mawson-rovers/hestia/hestia-pcb/images/hestia-back-angle-20220521.png

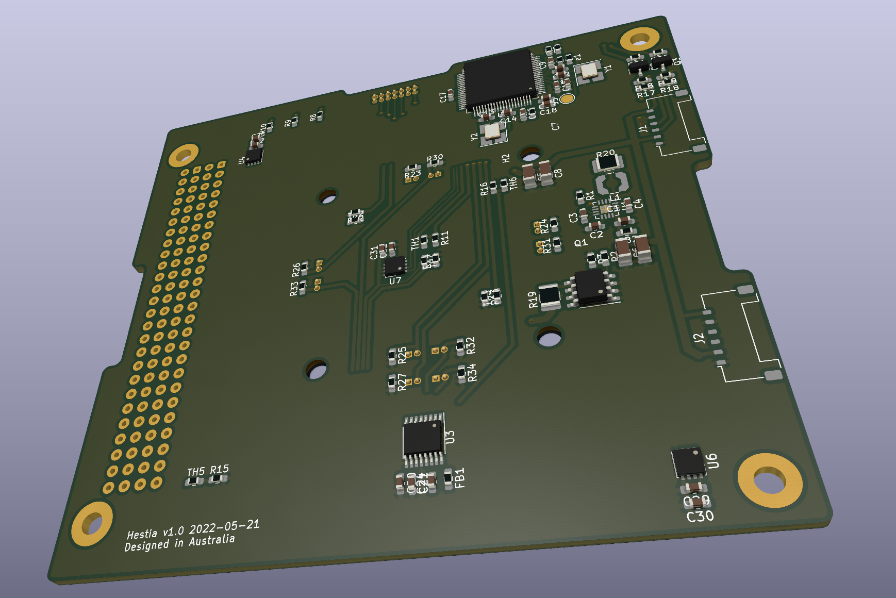
hestia-pcb/images/hestia-back-angle-20220521.png
