mawson-rovers/hestia/hestia-pcb/images/hestia-front-angle-20220521.png

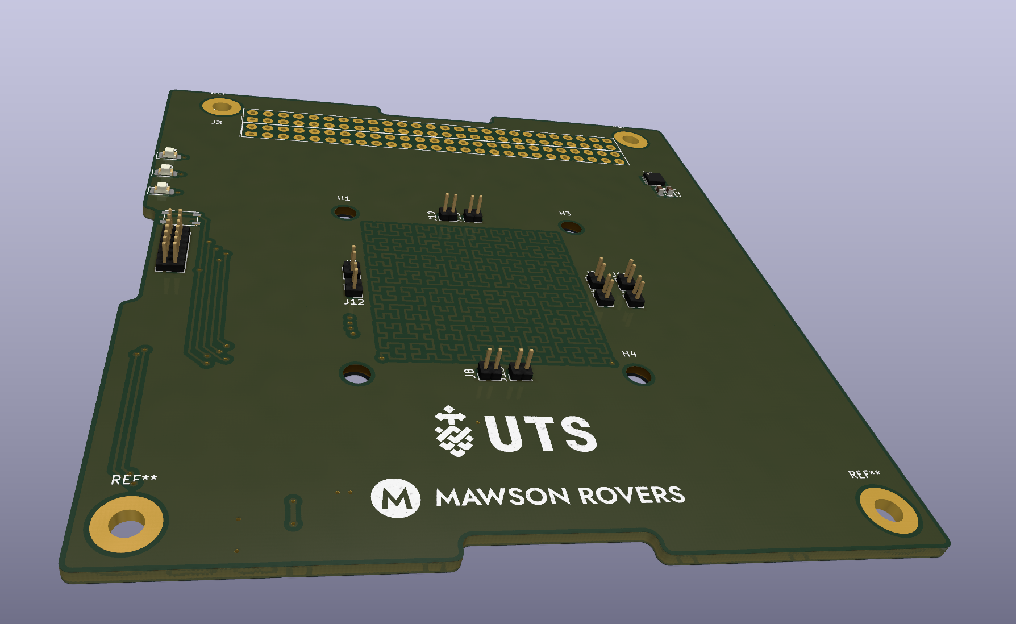
hestia-pcb/images/hestia-front-angle-20220521.png
