mawson-rovers/hestia/hestia-sat/BEAGLEBONE.md

## Setting up a BeagleBone Black

The Hestia software is designed to run on a BeagleBone Black (BBB) payload computer, connected to the Hestia board over I2C.

To set up a new BBB from scratch, you need to:

* Connect the BBB via USB to your computer, log in via SSH using `debian`/`temppwd`

* Configure internet sharing so the BBB can connect to the internet via the USB connection:
    * For Mac, enable Internet Sharing in the Sharing preference pane, then run `/opt/scripts/network/usb_mac_ics.sh` on
      the BBB
    * For Linux, you will need to configure NAT on the USB interface, then can run a similar
      script `/opt/scripts/network/`

* Install driver and configure the wi-fi with the TP-Link TL-WN725N dongle:

```sh
$ sudo apt update
$ sudo apt install git make gcc build-essential linux-headers-4.19.94-ti-r42
$ mkdir -p ~/src && cd ~/src
$ git clone https://github.com/lwfinger/rtl8188eu.git
$ cd rtl8188eu
$ make all
$ sudo make install
$ sudo reboot
$ sudo connmanctl
#connmanctl> tether wifi off
#connmanctl> enable wifi
#connmanctl> scan wifi
#connmanctl> services
#connmanctl> agent on
#connmanctl> connect wifi_*_managed_psk  # <- get this value from the services list above
#connmanctl> quit
```

(For the TP-Link AC600 Wi-Fi dongle - the one with the antenna - install the
[rtl8812au](https://github.com/aircrack-ng/rtl8812au.git) driver instead.)

### Update the hostname

Update the following files to set your Beaglebone to a unique hostname (we normally use b1, b2, etc).

* `/etc/hostname`
* `/etc/hosts`

Then change the hostname on the Avahi mDNS daemon. This allows you to ping `b7.local` (for example) over the network.

```sh
$ sudo hostname b7
$ sudo avahi-set-host-name b7
```

You just need to do this once; the OS and mDNS daemon will pick up the settings from `/etc/hostname` on the next reboot.

The Beaglebone should now be accessible via SSH over Wi-Fi.  Continue with the instructions in [INSTALL.md](INSTALL.md)
to install and configure the software.
