mawson-rovers/hestia/hestia-pcb/images/hestia-back-20220521.png

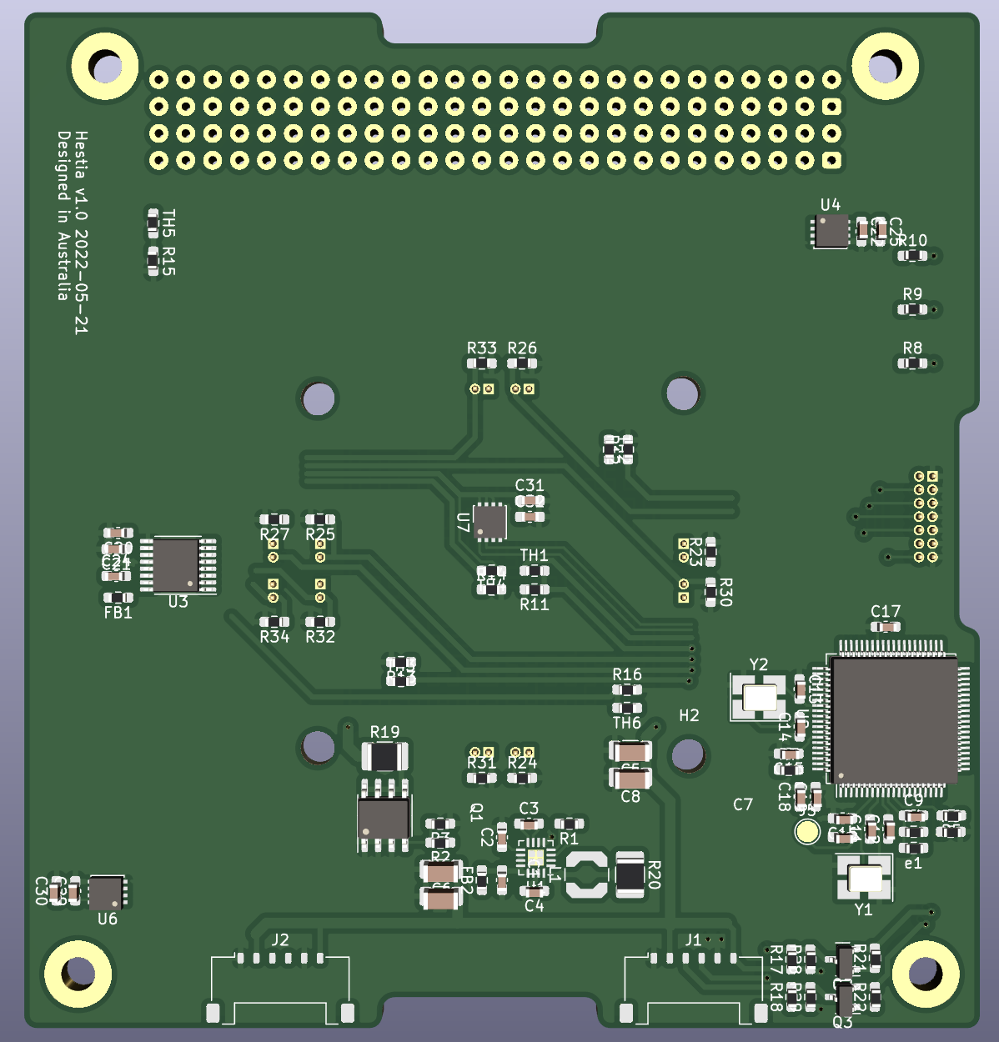
hestia-pcb/images/hestia-back-20220521.png
