mawson-rovers/hestia/ws-1/tcs-6u-main-asm-example.stp

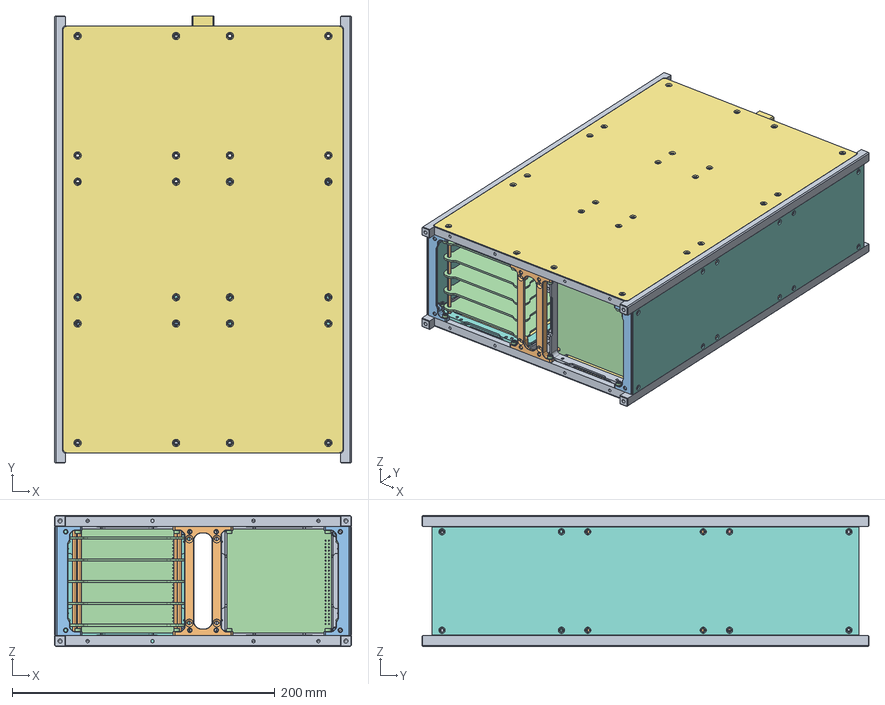
[picture p13: CAD file, 2022-05-23]
ws-1/tcs-6u-main-asm-example.stp
226.3 x 340.5 x 100.0 mm
ISIS-STSX-1-1-001 x 2
ISIS-STSX-1-1-002 x 6
ISIS-STSX-1-1-003 x 4
DIN912_M2_5X8 x 40
ISIS-STSX-1-1-005 x 2
ISIS-STSX-1-1-004 x 2
ISIS-STSX-1-1-006 x 2
ISIS-STSX-1-2-001 x 4
ISIS-STSX-1-2-002 x 4
ISIS-STSX-1-2-003 x 12
ISO14581_M2X6 x 32
PC104_PCB_REVD x 26
ISIS-STSX-1-2-004 x 4
ISO14581_M2_5X8 x 32
TCS-6U-BMSP-6U-EXAMPLE x 2
TCS-6U-BMSP-3U-EXAMPLE x 2
