mawson-rovers/hestia/hestia-pcb/3dmodels/Molex_Pico-Lock_504050-0691_1x06-1MP_P1.50mm_Horizontal.step

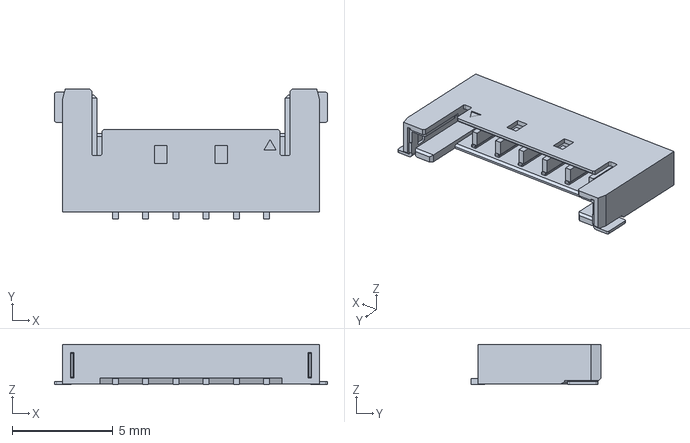
[picture p14: CAD file, 2023-07-20]
hestia-pcb/3dmodels/Molex_Pico-Lock_504050-0691_1x06-1MP_P1.50mm_Horizontal.step
13.6 x 6.44 x 2.00 mm
