mawson-rovers/hestia/hestia-sat/flight-programs/test7/test7.md

### Matilda Flight Test 7

Goals:

* Re-run FT2 test to replicate results and check for PCM leaks
  * Note: needs to be run during eclipse - same as XLB did on 27 Nov 2024 (see email)
* Run thermostat mode with target sensor on heatsink (J7) to test thermostat with PCM completely melted
