mawson-rovers/hestia/var/logs/ws1-test-2023-09-26/uts-data-1970-01-01-raw.csv

UTC | board | TH1 | TH2 | TH3 | U4 | U5 | U6 | U7 | TH4 | TH5 | TH6 | J7 | J8 | J12 | J13 | J14 | J15 | J16 | heater_v_high | heater_v_low | heater_curr | heater_mode | target_temp | target_sensor | heater_duty | max_temp | flags
1970-01-01 00:08:36.550837 | 1 | 2313 | 2246 | 2293 | 5932 | 5790 | 5800 | 8144 | 2331 | 1977 | 2248 | 2078 |  | 2083 | 2115 | 2092 |  |  | 3039 | 3036 | 4095 | 0 | 1044 | 0 | 255 | 3893 | 1
1970-01-01 00:08:36.550837 | 2 | 2211 | 2173 | 2202 | 5789 | 5689 | 5808 | 7248 | 2195 | 1958 | 2151 | 2055 |  | 2057 | 2065 | 2039 |  |  | 2956 | 61 | 23 | 2 | 1044 | 0 | 255 | 3893 | 1
1970-01-01 00:08:41.599771 | 1 | 2261 | 2223 | 2255 | 5951 | 5812 | 5818 | 7792 | 2278 | 1980 | 2226 | 2084 |  | 2088 | 2117 | 2093 |  |  | 3048 | 3036 | 4095 | 0 | 1044 | 0 | 255 | 3893 | 1
1970-01-01 00:08:41.599771 | 2 | 2323 | 2241 | 2299 | 5803 | 5701 | 5812 | 8002 | 2316 | 1960 | 2210 | 2051 |  | 2060 | 2067 | 2044 |  |  | 2959 | 61 | 23 | 2 | 1044 | 0 | 255 | 3893 | 1
1970-01-01 00:08:46.659794 | 1 | 2232 | 2211 | 2233 | 5971 | 5825 | 5826 | 7595 | 2247 | 1984 | 2212 | 2087 |  | 2087 | 2119 | 2091 |  |  | 3055 | 3036 | 4095 | 0 | 1044 | 0 | 255 | 3893 | 1
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
