mawson-rovers/hestia/var/logs/ws1-test-2023-09-26/uts-data-1970-01-01.csv

UTC | board | TH1 | TH2 | TH3 | U4 | U5 | U6 | U7 | TH4 | TH5 | TH6 | J7 | J8 | J12 | J13 | J14 | J15 | J16 | heater_v_high | heater_v_low | heater_curr | heater_mode | target_temp | target_sensor | heater_duty | max_temp | flags
1970-01-01 00:08:36.550837 | 1 | 31.51 | 29.83 | 31.01 | 23.17 | 22.62 | 22.66 | 31.81 | 31.97 | 23.31 | 29.88 | 25.72 |  | 25.84 | 26.61 | 26.06 |  |  | 4.97 | 4.97 | 3.35 | OFF | 0.86 | TH1 | 255 | 120.50 | OK
1970-01-01 00:08:36.550837 | 2 | 28.96 | 28.02 | 28.74 | 22.61 | 22.22 | 22.69 | 28.31 | 28.56 | 22.86 | 27.49 | 25.17 |  | 25.22 | 25.41 | 24.78 |  |  | 4.84 | 0.10 | 0.02 | PWM | 0.86 | TH1 | 255 | 120.50 | OK
1970-01-01 00:08:41.599771 | 1 | 30.20 | 29.26 | 30.05 | 23.25 | 22.70 | 22.73 | 30.44 | 30.63 | 23.38 | 29.33 | 25.86 |  | 25.96 | 26.66 | 26.08 |  |  | 4.99 | 4.97 | 3.35 | OFF | 0.86 | TH1 | 255 | 120.50 | OK
1970-01-01 00:08:41.599771 | 2 | 31.77 | 29.70 | 31.16 | 22.67 | 22.27 | 22.70 | 31.26 | 31.59 | 22.91 | 28.93 | 25.07 |  | 25.29 | 25.46 | 24.90 |  |  | 4.84 | 0.10 | 0.02 | PWM | 0.86 | TH1 | 255 | 120.50 | OK
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
