mawson-rovers/hestia/(threads)

Thread 15 (2023-01-23):

Test multiple boards on a single power supply, separate I2C buses

mryall-mawson, 2023-01-23:

mryall-mawson, 2023-07-10:
Tested and working via CLI:

* Enabled heater on top board, heated up to 100°C. Could see marginal increase in temperature (24°C → 26°C) on bottom board.
* Enabled heater on bottom board, heated up to 120°C, which disabled the top heater
* Confirmed logging includes both boards' data
* Confirmed CLI status shows both boards' temperature and targets.

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

Closed 2023-07-10.

Thread 24 (2023-02-06):

Test MSP430 ADC internal resistance with a known resistor divider

mryall-mawson, 2023-02-06:

mryall-mawson, 2023-06-20:
While debugging some issues, we have measured voltage and confirmed ADC behaviour on board v2. It's within 0.02V (<1% error).

Closed 2023-06-20.

Thread 28 (2023-05-29):

Electronics fixes for v2.1

mryall-mawson, 2023-05-29:
Things to tidy up:
* Footprints for inductor, diodes, etc.
* LED resistors - red & blue bright
* Update KiCAD
* Increase diameter/spacing of SW2

JDMawson, 2023-06-17:
inductor footprint changed. diode footprint changed. Most of DRC issues resolved. Mawson Rovers logo and UTS logo need to be rereferenced from the Hestia footprint libraries but they seem to be different sizes from those in the libraries. Maybe the better solution is to create new library footprints from the logos already on the PCB. Smartsat and SpiralBlue logos seem to be only on the PCB and not referenced from libraries but are listed as footprint elements. Perhaps they can also be copied into footprint libraries and referenced. The logos should be given different footprint designator names.

JDMawson, 2023-06-18:
i think I've finished shifting all the designators and adding text. DRC is satisfied.

JDMawson, 2023-06-18:
having a look at the build artifacts. How are some components being excluded. i see most of the thruhole have been removed from the BOM but there is still one thruhole component present in the BOM. Would it be possible to create two BOM files - one for SMD and one for thruhole?

mryall-mawson, 2023-06-20:
@JDMawson I had a look at the BOM config in the [hestia.kibot.yml](https://github.com/mawson-rovers/hestia/blob/main/hestia-pcb/hestia.kibot.yml) config file, and can't see any reason why THT components would be (mostly) excluded. I think manual export from KiCAD is probably easiest at this stage, and we can look into automating it as a later enhancement.

Closing this issue off as the original items have been fixed. Issue #38 covers the problem with the current measurement, and issue #35 covers the heater trace. I'll raise a new one for the actual fabrication too.

Closed 2023-06-20.

Thread 29 (2023-05-29):

Rolling average sampling for voltage & current measurement

mryall-mawson, 2023-05-29:
Need to ensure this works correctly with PWM as well.

Closed 2023-09-26.

Thread 30 (2023-05-31):

Implement voltage & current measurement

mryall-mawson, 2023-05-31:
We have the circuitry, now need to implement the software:

* Ensure firmware can correctly read from ADC
* Convert values to voltages and current in software
* Add to logger and web API
* Adjust UI to show values on chart and status panel

Closed 2023-06-18.

Thread 32 (2023-06-06):

Log other data even if check sensor fails

mryall-mawson, 2023-06-06:
CLI should use the check sensor to prevent delays, but the logger can rely on config to disable boards that aren't available.

mryall-mawson, 2023-06-21:
This was mostly a problem when the I2C pins were not configured. Now that they are configured correctly on the Beaglebone (via config-pin), the read operations return quickly if there is no signal.

Closed 2023-06-21.

Thread 34 (2023-06-19):

Use green LED as PID indicator

mryall-mawson, 2023-06-19:
The current firmware is flashing the green LED every 1s based on the timer. We should make this flash only when PID mode is operating, so it works as an indicator.

mryall-mawson, 2023-06-20:
Tested and confirmed working

Closed 2023-06-20.

Thread 35 (2023-06-19):

Heater trace resistance too low on board v2

mryall-mawson, 2023-06-19:
When connected to 5V power supply, we see current above 3A. Measured heater trace resistance on board v2 is 1.6Ω vs 2.2Ω in board v1.1.

After discussion with @JDMawson we agreed to reduce track width to compensate, from 0.28mm to 0.18mm. This should increase resistance to the desired 2.5Ω.

Root cause unclear. Perhaps PCBWay (v2 manufacturer) copper is thicker than JCLPCB (v1.1 manufacturer), or there is a difference in the physical stack-up we chose.

mryall-mawson, 2023-06-19:
Need to confirm this fix when we get board v2.1 back.

mryall-mawson, 2023-07-03:
Tested a variety of heater trace widths on 4-layer boards from PCBWay and found that we need to use a 0.15mm track width, plus some manual testing to verify resistance is high enough before board loading.

Added a test pad TP7 on the low side of the heater for easy manual testing during fabrication.

Closed 2023-07-03.

Thread 36 (2023-06-20):

Can't update via web interface, buttons don't work

mryall-mawson, 2023-06-20:
Web interface wasn't working during testing last night. Had to use CLI to turn heater on and off.

Found an error about "Origin not permitted" in the JS log files.

Closed 2023-06-20.

Thread 38 (2023-06-20):

Current measurement via INA826 is not working correctly

mryall-mawson, 2023-06-20:
Measured via a multimeter in series, we can see current of >3A, while the ADC is reporting ~1.7V.

Testing has confirmed the instrumentation amp (part INA826; designator U10) is reporting a lower than expected voltage.

Current theory is that we may have connected the REF pin on INA826 incorrectly, but needs further investigation.

mryall-mawson, 2023-06-20:
Confirmed that if the input starts at 3.2A, then down to 2.2A, then back up to 3.2A again, that the measured current on the INA826 does decrease (1.67 → 1.61) and then rise slightly (1.60 → 1.65):

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

Here's the raw data:

```csv
2023-06-20 05:01:27.442862,2,24.47,24.45,25.26,24.34,23.70,23.68,24.74,24.24,24.26,24.28,,,,,,,,5.01,5.00,0.01,OFF,79.98,TH1,255
2023-06-20 05:01:32.472310,2,25.98,26.54,27.83,24.35,23.71,23.67,26.04,25.82,24.26,26.30,,,,,,,,4.22,0.08,1.71,PWM,79.98,TH1,255
2023-06-20 05:01:37.501913,2,34.43,38.59,42.80,24.36,23.71,23.70,34.92,34.72,24.26,37.12,,,,,,,,4.24,0.08,1.70,PWM,79.98,TH1,255
2023-06-20 05:01:42.533126,2,40.81,48.16,55.23,24.39,23.71,23.74,42.54,41.43,24.31,45.65,,,,,,,,4.24,0.08,1.69,PWM,79.98,TH1,255
2023-06-20 05:01:47.562953,2,45.45,55.23,64.63,24.49,23.77,23.84,48.34,46.32,24.33,52.06,,,,,,,,4.50,0.07,1.67,PWM,79.98,TH1,255
2023-06-20 05:01:52.594303,2,49.07,60.61,72.03,24.67,23.80,23.97,52.90,50.07,24.40,57.11,,,,,,,,4.28,0.07,1.67,PWM,79.98,TH1,255
2023-06-20 05:01:57.623850,2,51.20,64.09,76.73,24.85,23.88,24.14,55.89,52.39,24.50,60.12,,,,,,,,3.31,0.06,1.61,PWM,79.98,TH1,255
2023-06-20 05:02:02.654415,2,50.88,63.37,75.99,25.12,23.98,24.32,55.97,52.03,24.62,59.68,,,,,,,,3.31,0.06,1.60,PWM,79.98,TH1,255
2023-06-20 05:02:07.699872,2,50.81,62.85,75.40,25.39,24.10,24.54,56.02,52.10,24.76,59.42,,,,,,,,3.33,0.14,1.60,PWM,79.98,TH1,255
2023-06-20 05:02:12.740105,2,51.23,62.80,75.60,25.64,24.24,24.76,56.41,52.47,24.95,59.60,,,,,,,,3.30,0.06,1.60,PWM,79.98,TH1,255
2023-06-20 05:02:17.768084,2,51.95,63.13,75.53,25.93,24.39,24.98,57.00,53.13,25.14,59.86,,,,,,,,3.31,0.06,1.60,PWM,79.98,TH1,255
2023-06-20 05:02:22.795785,2,52.69,63.51,75.73,26.19,24.61,25.25,57.70,53.85,25.31,60.21,,,,,,,,3.34,0.06,1.60,PWM,79.98,TH1,255
2023-06-20 05:02:27.825523,2,54.07,64.77,77.20,26.45,24.80,25.50,58.99,55.31,25.58,61.32,,,,,,,,4.28,0.07,1.65,PWM,79.98,TH1,255
2023-06-20 05:02:32.855403,2,57.65,69.16,82.66,26.68,25.04,25.73,62.66,58.99,25.82,65.17,,,,,,,,4.29,0.07,1.64,PWM,79.98,TH1,255
2023-06-20 05:02:37.888113,2,60.61,72.82,87.95,26.90,25.27,25.98,66.04,62.15,26.08,68.34,,,,,,,,4.29,0.07,1.64,PWM,79.98,TH1,255
2023-06-20 05:02:42.917952,2,63.13,75.66,91.31,27.17,25.47,26.26,68.86,64.73,26.30,71.03,,,,,,,,4.31,0.07,1.63,PWM,79.98,TH1,255
2023-06-20 05:02:47.947541,2,65.17,77.97,94.47,27.39,25.74,26.49,71.22,66.80,26.54,72.88,,,,,,,,4.30,0.07,1.63,PWM,79.98,TH1,255
2023-06-20 05:02:52.977904,2,66.96,79.90,96.73,27.70,25.97,26.79,73.34,68.78,26.81,74.56,,,,,,,,4.31,0.07,1.63,PWM,79.98,TH1,255
2023-06-20 05:02:58.007708,2,68.83,81.64,99.02,28.06,26.20,27.03,75.27,70.51,27.02,76.26,,,,,,,,4.31,0.07,1.62,PWM,79.98,TH1,255
2023-06-20 05:03:03.039182,2,70.40,83.22,101.07,28.34,26.46,27.30,77.06,72.21,27.32,77.62,,,,,,,,4.31,0.07,1.62,PWM,79.98,TH1,255
2023-06-20 05:03:08.078846,2,71.91,84.45,102.55,28.68,26.70,27.59,78.63,73.74,27.56,78.89,,,,,,,,4.31,0.07,1.62,PWM,79.98,TH1,255
2023-06-20 05:03:13.108327,2,73.12,85.64,103.94,28.98,26.93,27.84,80.12,75.33,27.78,79.83,,,,,,,,4.30,0.07,1.61,PWM,79.98,TH1,255
2023-06-20 05:03:18.138152,2,71.68,82.26,100.16,29.29,27.19,28.13,78.82,73.43,28.10,76.93,,,,,,,,4.99,4.99,0.01,OFF,79.98,TH1,255
```

mryall-mawson, 2023-06-23:
@JDMawson I've tested a variety of currents through the heater trace & INA826, and in its existing configuration on board H202:

* Values up to ~1.5A are measured correctly. I got accurate measurements for 0.25A, 0.5A, 1.0A, 1.2A, 1.4A and 1.5A (comparing the power supply output to the log files).
* Values above 1.5A are truncated to a measurement of ~1.5-1.6. 1.6A measured as 1.55, 2A measured as 1.57.

My theory - with REF set to ground and supply rails of 0V/3.3V, we have configured the INA826 with a range of 3.3V around an offset of 0V. So the current configuration can measure from -1.65A to 1.65A, and the resolution decreases a bit near the edges.

Perhaps changing the REF pin to 1.65V would give us the expected range of 0-3.3V for an input current of 0-3.3A. Let's see how it works on the evaluation board.

mryall-mawson, 2023-07-10:
JD and I implemented a basic current sense resistor as a replacement to the amplifier on board v2.1.

It doesn't use the full range of the ADC, so we don't get very accurate measurement, and it uses a bit more power, but should still be okay.

Closed 2023-07-10.

Thread 39 (2023-06-20):

Show heater_duty on chart

mryall-mawson, 2023-06-20:
New uts-web interface doesn't show duty on chart.

We should show it with a range of 0.0-1.0, scaled appropriately for the heater mode (PID: 0-1000, PWM: 0-255).

Closed 2023-06-20.

Thread 40 (2023-06-20):

Get B3 + H113 setup working for testing

mryall-mawson, 2023-06-20:
Need to get back to a working version of the dashboard and firmware.

mryall-mawson, 2023-06-21:
I've updated the new software to work with the old board. It's a bit crufty, showing irrelevant voltage/current fields & lines, but it works as a stopgap.

Closed 2023-06-21.

Thread 41 (2023-06-20):

Submit order for v2.1 boards

mryall-mawson, 2023-06-20:
Submit an order once all the open issues in the [board-v2.1 milestone](https://github.com/mawson-rovers/hestia/milestone/2) are closed:

- #28
- #35
- #38

Closed 2023-07-10.

Thread 43 (2023-06-21):

Test board for various heater trace designs

mryall-mawson, 2023-06-21:
We should do a quick test board with heater traces of various widths, so we can confirm the resistance before fabricating the final board.

mryall-mawson, 2023-06-21:
I designed a test board with four heater traces, using track widths of 0.16, 0.18 (proposed new), 0.22 and 0.28 mm (original). KiCAD files for the PCB design are committed here: https://github.com/mawson-rovers/heater-trace-test

I've sent two versions off for fabrication with PCBWay tonight. The 2-layer version costs $5 and has a 24h turnaround time, so I made one of those even though the copper thickness may not be representative. The real test is a 4-layer board, which is estimated to take 4-5 days for fabrication, then another 3-4 days for shipping.

Closed 2023-06-21.

Thread 44 (2023-07-03):

New software can’t read all sensors on v1.1 boards

mryall-mawson, 2023-07-03:
The Python code seems to read a bunch of sensors that the new Rust code can’t. Needs investigation when we get a v1.1 board back in the office.

mryall-mawson, 2023-10-16:
Not fixing this.

Closed 2023-10-16.

Thread 45 (2023-07-03):

Timestamps out of order in log files

mryall-mawson, 2023-07-03:
There’s some kind of intermittent logging issue where older timestamps are interspersed with newer ones.

Laryssa sent an example that I’ll post here shortly.

mryall-mawson, 2023-07-20:
Laryssa showed me an example of this at Tech Lab today. It looks like the following happens from the perspective of the Beaglebone system:

- Time t1: log some sensor data
- t2: store the current time (t2) in some kind of non-volatile storage in case of a power/network failure
- t3: log more sensor data
- t4: power is disconnected, system halts
- t2': power is restored, system restarts and starts logging data again, but starting from the stored timestamp t2
- t3': sensor data is logged with timestamp t3 again
- t8: when system reconnects to the internet (via LSR's phone), ntp updates the time to t8
- t9: sensor data is logged

I'll need to look into the BBB clock hardware more to see if there's a way to keep the clock ticking when the system is powered down. Without that, I think this might be a limitation we just have if we need to power it down between tests.

mryall-mawson, 2023-07-27:
There are real time clock (RTC) capes for the Beaglebone Black, but it seems like too much effort to implement and test this so late in the project.

So closing this for now - we can look at it for a future project if needed.

Closed 2023-07-27.

Thread 46 (2023-07-03):

Allow setting custom heater duty via web interface

mryall-mawson, 2023-07-03:
Request from Nick:

> For some testing that I’m doing + the solid-solid PCM it seems like we could do with lower heater duty cycles than 10%. Would it be time consuming to add a few more buttons, or even some sort of slide scale/input to give many more options? I think for some of the tests going as low as 1%.

mryall-mawson, 2023-07-03:
We implemented this feature yesterday at UTS and deployed on all three Beaglebones there.

There is now a text box for a custom duty level, and an "Apply" button to apply it. Values between 0.0 and 1.0 are accepted, and converted to a 0-255 value in JavaScript.

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

Closed 2023-07-03.

Thread 50 (2023-07-10):

Implement programs for payload experiments on-orbit

mryall-mawson, 2023-07-10:
Create a new binary `uts-run` that does the following:

* Read `uts-programs.toml` config file with the programs and run order from the spreadsheet linked in #42
* Set up a state machine with a state for each program instance, and transitions based on the criteria for each program
* Periodically check if the conditions are met (time, temperature, etc) and move through the state machine accordingly.

Also consider whether to implement temperature abort in firmware rather than software.

mryall-mawson, 2023-07-18:
Tested and working on two boards. See dashboard screenshot below.

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

Configuration is deployed in `~/uts/uts-programs.toml` on B4, and looks like this:

```toml
loop = false

[[programs]]
heat_board = "Bottom"
heat_time = "60s"
heat_duty = 1.0
temp_sensor = "TH1"
temp_abort = 90.0
thermostat = 80.0
cool_time = "1m 30s"

[[programs]]
heat_board = "Bottom"
heat_time = "30s"
heat_duty = 0.5
temp_sensor = "J7"
temp_abort = 60.0
cool_time = "60s"

[[programs]]
heat_board = "Top"
heat_time = "60s"
heat_duty = 1.0
temp_sensor = "TH1"
temp_abort = 90.0
thermostat = 80.0
cool_time = "1m 30s"
```

Currently programs can only be run from the command line. Configuring and running them via the web interface will be another task.

Closed 2023-07-18.

Thread 52 (2023-07-19):

Programs should allow cooling to temperature

mryall-mawson, 2023-07-19:

mryall-mawson, 2023-07-20:
Replaced cool_time with cool_temp in c318d5d64d665040e2b662148090a889c58a363b.

Closed 2023-07-20.

Thread 53 (2023-07-19):

Web interface for running/editing programs

mryall-mawson, 2023-07-19:

mryall-mawson, 2023-07-20:
Workaround for now is to use the Cloud9 IDE on the Beaglebone through a web browser:

* Go to http://b3.local (no port 5000)
* From the cog icon on the left tree, enable "Show home in favourites"
* Open up the home directory ("~"), find and open "uts", then double-click "uts-programs.toml" to edit the programs
* You can ignore specific programs by putting "# " at the start of each line, or just delete them. There is no limit to how many you can run. Change "loop = false" to "loop = true" at the top for it to repeat the script over and over again.
* In the command line below, type the following:

```sh
UTS_PROGRAM_FILE=$HOME/uts/uts-programs.toml RUST_LOG=info uts-run
```

This will run your program. If you need to stop it, hit Ctrl-C.

If you stop the program and the heater is still running, you can use the web interface or CLI (command line interface) tool to stop the heater manually:

```sh
uts-cli heater -b 2 off
```

This turns off the heater on the board on bus "2" (which will be the bottom board), which is all the test boards at Tech Lab currently.

mryall-mawson, 2024-02-05:
Not doing this for now.

Closed 2024-02-05.

Thread 55 (2023-07-20):

Holes do not match PC/104 standard

mryall-mawson, 2023-07-20:
Identified by CUAVA with the CAD, and then confirmed in KiCad and by a fit test at UTS.

Looks like the holes got moved slightly (up to 0.4mm) early in the design, and we never revalidated it. This has been a problem since at least the v1.1 boards.

We can workaround it for the current versions, but still need to fix the board design and send a new CAD to the team.

(While doing a new CAD, we should also work out how to include the Pico-Lock connector shroud 3D models.)

mryall-mawson, 2023-07-20:
PCB design has been fixed. New STEP file can be found in the build artifacts here: https://github.com/mawson-rovers/hestia/actions/runs/5611578622

Now we need to work out how to physically fix some of the existing boards, as we do not have time to manufacture more. Current plan is to make a drill template with H5 and H7 holes for fixing the PCB, and H6 in the new location for drilling. Then we'll drill through a buffer layer on top/bottom to minimise damage to the PCB.

Closed 2023-07-27.

Thread 56 (2023-07-27):

Support for running programs with just one board

mryall-mawson, 2023-07-27:
Currently running programs with just one board (e.g. configured via `UTS_I2C_BUS=2`) fails because the program logic expects to be able to query both boards.

Enabling both boards means lots of errors appear in the output, so this is not a good workaround.

Closed 2023-07-27.

Thread 57 (2023-08-10):

Add software thermal limit

mryall-mawson, 2023-08-10:
We have run out of time to thoroughly test the physical thermal switch, so will implement the switch in software.

It should turn off the heater if we read a temperature over 120°C on any of the sensors connected to the MCU.

mryall-mawson, 2023-08-10:
Limit implemented in firmware, with read/write I2C commands. Defaults to 120°C, and can be disabled by setting to zero. Tested on board H203 with the default limit.

Still need to update logger, CLI, etc. for control and logging, and do a bit more testing.

mryall-mawson, 2023-08-10:
Some quick example i2cget commands used for testing - showing reading max temp (3893 in ADC value), board version (200) and status (1 = OK):

```
$ printf "%d\n" $(i2cget -y 2 0x08 0x24 w)
3893
debian@b5:~$ printf "%d\n" $(i2cget -y 2 0x08 0x10 w)
200
debian@b5:~$ printf "%d\n" $(i2cget -y 2 0x08 0x11 w)
1
```

Noticed a minor bug that the I2C interface returns the previous value when an unknown command is received.

mryall-mawson, 2023-08-10:
Tested with reducing limit to 60°C while running a program and confirmed it worked as expected. Heating is aborted, program continues until time limit reached, then starts cool cycle as normal.

Closed 2023-08-15.

Thread 58 (2023-08-10):

uts-run loop doesn't work

mryall-mawson, 2023-08-10:
When you enable looping, it fails with the following message:

`thread 'main' panicked at 'Didn't find any programs', src/bin/uts-run/main.rs:149:42`

Closed 2023-08-10.

Thread 59 (2023-08-10):

I2C reads return stale data for unknown commands

mryall-mawson, 2023-08-10:
If the I2C interface receives an unknown command, it currently replies with the data from the previous command.

It should either not reply (if possible) or reply with a sentinal failure value.

Thread 60 (2023-08-14):

Add test script to CLI

mryall-mawson, 2023-08-14:
Need an equivalent of the test we used at CUAVA last time, which used the Python code.

It should do a test of both boards, checking sensors are working, heater works, etc.

Closed 2023-08-14.

Thread 61 (2023-09-21):

Thermostat PID loop doesn't hit target temp

mryall-mawson, 2023-09-21:
At higher temperatures, the PID loop doesn't quite reach the target temperatures.

We need to tune it to match the responsiveness of the heater when it has a big heatsink on it.

mryall-mawson, 2023-09-26:
Fixed and tested at a variety of temperatures.

Closed 2023-09-26.

Thread 63 (2023-09-26):

I2C interface not working on some v2.2 boards

mryall-mawson, 2023-09-26:
Looks like a problem with the I2C buffer we're using, LTC4313-1. Watching the I2C lines with an oscilloscope on the board side shows no signal when the Beaglebone is transmitting messages.

mryall-mawson, 2023-10-11:
JD has fixed and tested all the v2.2 boards now. PCB design still needs fixing.

mryall-mawson, 2024-01-16:
Fixed in PCB design

Closed 2024-01-16.

Thread 67 (2023-10-11):

Add syslog option for output, remove any unnecessary logging

mryall-mawson, 2023-10-11:
WS-1 needs us to log output to syslog, not stdout.

There is also quite a bit of logging if one of the boards is non-responsive. It filled up one of my Beaglebones here with 300MB of logs. We should fix that so it is one log message per attempt, instead of 10-12 lines.

mryall-mawson, 2023-10-11:
I started some work on this on the `syslog` branch but didn't get around to testing it:

https://github.com/mawson-rovers/hestia/commit/6d1c36f965f9f69e89682a0ccbc926b81b5f9545

cowen-mawson, 2023-10-24:
Splitting the syslog task from the reduce logging task which is now tracked at #70

mryall-mawson, 2023-10-30:
Done - needs testing with USyd.

Closed 2023-10-30.

Thread 68 (2023-10-16):

Current measurement is finnicky

mryall-mawson, 2023-10-16:
Low-pass filter doesn't seem to be working properly.

mryall-mawson, 2024-02-26:
Notes from discussion with @JDMawson, Mon 19 Feb:

* Agreed ADC sampling frequency should be increased by switching to MCLK (5 → 16 MHz) and decreasing sample hold time from 256 cycles to 96 (SHT0_8 → SHT0_5)
* Agreed we should align PWM with ADC sampling, so samples are taken immediately after (not during) MOSFET transitions
* Discussed PWM requirements for Hestia 2W:
  * UTS need configurable power range of 0-2W in 0.1W increments (20 gradations).
  * Boards are likely 6-7W, so PWM range will be 0-30% duty with resolution of 1 percentage point.
  * Frequencies lower than 600 Hz should be fine, as long as power source (USB battery pack) doesn’t switch off. (Is our input capacitance sufficient?)
* We have flexibility to use calculation instead of measurement if we like. So if measurement is not possible or inaccurate due to PWM, we can statically measure resistance (at various temps) on each board and use this to derive an expected duty/temp-vs-power curve.
  * I’m anticipating calculation might be best approach for low duty loads (<5%), where only one measurement can be taken.

Next steps:
* Test aligning PWM with ADC sampling
* Add signals for tracking end of interrupt handler and main loop execution, to ensure that these are only running when expected.
* Use electronic load to check ADC current measurements against a known voltage+current.

mryall-mawson, 2024-08-12:
Voltage measurement reliability is now fixed by porting over the changes made to Hestia 2W, where we make sure the ADC measurements and PWM switching is timed appropriately.

Current measurement is still problematic on v2.2 due to the op amp issue, which is not fixable unfortunately.

Laryssa is going to use some resistance measurements taken at various temperatures to calculate power dissipation based on the voltage.

Closed 2024-08-12.

Thread 70 (2023-10-24):

Remove unnecessary logging

cowen-mawson, 2023-10-24:
There is quite a bit of logging if one of the boards is non-responsive. It filled up one of my Beaglebones here with 300MB of logs. We should fix that so it is one log message per attempt, instead of 10-12 lines.

mryall-mawson, 2024-02-05:
If one of the boards fails, that is a major problem, so a lot of logging is probably an appropriate response. Closing this.

Closed 2024-02-05.

Thread 73 (2023-11-20):

Compress data log files for downlinking

cowen-mawson, 2023-11-20:
At the moment, Hestia log files are written to disk as uncompressed csv files. As bandwidth for downlinking from the satellite will be at a premium (and the downlink protocol not having built in compression support) we should choose a compression format for the files which can be downlinked from the satellite efficiently.

mryall-mawson, 2024-01-24:
Based on advice from CUAVA, we need to switch to gzip encoding, so I've made the change and opened a PR here: https://github.com/mawson-rovers/hestia/pull/79

But while testing this change, I realised that the compression for the log files isn't very effective in its current implementation because it is only compressing 2 lines at a time, because we open and close the file for every write.

For a 120-line log file with 19 KB of (dummy) data, the current streaming implementation resulted in a compressed output of 13 KB. Compressing the whole file with `gzip -1` results in a file size of 1 KB.

So I think we should change the way it works to compress log files in bulk. Probably easiest to do it in uts-log when it starts up, and whenever a day ticks over. We can just go through all the files in the UTS_LOG_PATH directory and gzip them up.

I'll take a look at this tomorrow, and put all the changes on that PR against this ticket.

mryall-mawson, 2024-01-31:
Tested manually and works on WS-1.

Added to the flight schedule to be run before downlink as `uts-cli zip`.

Closed 2024-01-31.

Thread 76 (2024-01-18):

TVac testing scripts

mryall-mawson, 2024-01-18:
Requirements:
* 2 tests required - one for each board
  * Low temperature hold at -10°C - run heat & cool cycle on top/bottom
* Not doing test at high temperature hold

Current testing process at CUAVA:
* `cd UTS`
* `uts-cli test`

Suggested interface for CUAVA:
* `uts-cli run programs/tvac1.toml` - bottom, temp_abort = 85, default settings otherwise
* `uts-cli run programs/tvac2.toml` - top, temp_abort = 85, default settings otherwise

Use existing functionality from uts-run (which loads from UTS_PROGRAM_FILE) to load from tvac-1.toml, tvac-2.toml, etc.

Need to run uts-log in the background, like we do with systemd on test BBB. Could use CubeOS scheduler? Or another way to run system services? Want to capture data before/after uts-cli execution.

Schedule for TVac:
* start `uts-log` as soon as possible after boot
* ensure log output going to `$UTS_LOG_PATH`
* run `uts-cli run tvac-1.toml`, etc. manually at specified times

cowen-mawson, 2024-01-19:
From Nick:

> For the TVac test we’ll go for the following:
Full power test
Cut off temp, 85C (measured by TH1)
No high-temp test after all

mryall-mawson, 2024-01-31:
Tested manually via `uts-cli run ...`, and works correctly.

Waiting for scheduler to be working on WS-1 to finalise this.

mryall-mawson, 2024-02-09:
Scheduler is now working. Waiting to receive execution logs to confirm it is running the scripts properly.

mryall-mawson, 2024-02-29:
Fully tested today with the scheduler. We ran both tvac1 and tvac2 schedules, and got the associated data back to UTS.

Some minor remaining issues for CUAVA to fix:
- File transfer fails with spurious error at the end, even though it was successful
- Processes started by the scheduler aren't terminated when the schedule is stopped
- Scheduler periodic tasks don't seem to run periodically (which we are now doing with the `zip` task).

Closed 2024-02-29.

Thread 78 (2024-01-22):

Hestia 2W board cleanup

mryall-mawson, 2024-01-22:
Ideas of components to remove:

* J1 - Serial connector - replace with holes/pads for debug
* U8 - serial voltage converter
* U9 - I2C buffer
* Y1 & Y2 - check usage of crystals
* U3, TH4-6, J12-16 - ADC & associated temp sensors
* U4, U5, U6 - but keep U7 (centre)

mryall-mawson, 2024-01-23:
Done on the `hestia-2w` branch.

Removed all components listed above except the crystals, in case we need them for more accurate ADC measurements.

Closed 2024-01-23.

Thread 88 (2024-02-09):

Program runner doesn't disable an already-on heater

mryall-mawson, 2024-02-09:
The payload should never turn on two heaters at the same time, so the program runner should (at least attempt to) disable all heaters before turning any of them on.

It doesn't do this at the moment.

Closed 2024-02-09.

Thread 89 (2024-02-21):

Oscillating temperature readings on board H112 when power < 1.0

mryall-mawson, 2024-02-21:
Reported by UTS:

> Our new team member is running some tests with board H112 and BeagleBone B2 at different power levels. She noticed the data points for TH1 get quite noisy for power levels lower than 1.0, see below for 0.2, 0.6 and 1.0 and attached.

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

Data: [Testing Power Levels - 0.2 - 0.6 - 1.0 for Titanium.xlsx](https://github.com/mawson-rovers/hestia/files/14366014/Testing.Power.Levels.-.0.2.-.0.6.-.1.0.for.Titanium.xlsx)

I suggested using the I2C integrated sensors (U4, U5, etc.) since they don't seem to have the same fluctuations. So the team is using U7 temporarily because it tracks closely to TH1.

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

They further noted that this is specific to H112:

> I didn’t find this issue neither on the V2 boards nor on H113 board, so might be specific to H112.

mryall-mawson, 2024-02-21:
Could be related to #2, which was fixed for v2.

mryall-mawson, 2024-02-26:
Tested on v2.2 board here and could not reproduce. Power level 0.2 had smooth readings on TH1. So this seems specific to the old board.

I'm looking at electronics differences between v1.1 and v2 now. The regulator changes which we made to fix #2 are almost certainly the root cause. We'll need to get a photo of the H112 board to see if any bodges were already applied to try to fix it.

mryall-mawson, 2024-02-29:
This issue is specific to board H112, and we believe it is due to the bodge fix made to address issue #2, which was fixed with board v2.0 and later.

Given there are higher priority issues to tackle ahead of the launch, we are not going to do any further hardware fixes to this board at the moment.

Closed 2024-02-29.

Thread 90 (2024-02-26):

Improve CLI commands when working with a single board

mryall-mawson, 2024-02-26:
Many of the CLI commands require `-b` arguments to specify which board to use, even when only one board is attached. This makes the CLI more painful to use than necessary.

There are also some smarts in the heater command, to attempt to disable the heater on the other board, even if only one board is connected. This ends up spewing out errors even in a correctly configured environment.

I think there are also some other commands which ignore the UTS_I2C_BUS setting, and try to connect to multiple boards, even when configured with only one. This seemed like a good idea at the time, but now it is just annoying.

Closed 2024-02-29.

Thread 91 (2024-02-27):

Hestia 2W manufacturing updates

mryall-mawson, 2024-02-27:
Some part changes/clarifications found during Hestia 2W board manufacturing:

* Q1 - part FDS8876 is now obsolete. Updating to AO4576.
* D7 - label should be BAT54SW which has a SOT-323 footprint, not BAT54S which uses SOT-23.

More may be added as we find issues.

Thread 95 (2024-03-25):

Log status periodically during program execution

mryall-mawson, 2024-03-25:
During TVac testing, it was helpful to have periodic logging, showing the heating/cooling status and a temperature every 1 minute, instead of only when transitioning between stages.

I implemented this as a quick fix, but we need to do it in a way that can be disabled or much less verbose during flight so we don't fill up the host log files with useless messages.

Thread 96 (2024-03-26):

Setting to disable logging when board is missing

mryall-mawson, 2024-03-26:
We had an issue recently with Beaglebone B4, which was configured to read from the top board (`UTS_I2C_BUS=1` in the `uts-log.service` file), but the Hestia board was physically connected via the bottom connector (I2C2). Some testing was done, and the test data was lost.

It would be ideal if we could leave the test rigs configured to read from both boards, but the errors when sensors are not found could be silenced, so we don't fill up the Beaglebone disk with errors if a board isn't connected.

This would allow the standard configuration to use `UTS_I2C_BUS=1,2`, and it would just leave the log files blank if a board wasn't connected to one of the buses.
