mawson-rovers/hestia/hestia-fw/main.c

//******************************************************************************
//   Hestia firmware for MSP430F2618.
//
//   I2C interface and control logic for the Hestia circuit board.
//******************************************************************************

#include <msp430.h>

#if defined(__GNUC__)

#include <in430.h>

#endif

#include <stdint.h>
#include <stdbool.h>
#include "main.h"
#include "i2c.h"

union I2C_Packet_t message_tx;

volatile unsigned int adc_readings[ADC_SENSOR_COUNT];
volatile unsigned int adc_avg[ADC_SENSOR_COUNT];
unsigned int control_sensor = 0; // ADC input used for PWM control
unsigned int set_point = TEMP_0C;
unsigned int board_status = BOARD_STATUS_ON;
unsigned int heater_mode = HEATER_MODE_OFF;
unsigned int pwm_duty = HEATER_PWM_DUTY_DEFAULT; // 8 bit resolution
unsigned int counter = 0;
unsigned int max_temp = TEMP_120C; // Set to zero to disable max_temp check

// PID control variables
#define K_P         3       // PID proportional gain
#define K_I_SHIFT   3       // PID integral shift right bits
#define MAX_OUT     8000
#define MIN_OUT     0

// exponential moving average (EMA) control values
const uint8_t K = 6;                // fixed point position; smoothing factor = 2 ^ -K
const uint16_t half = 1 << (K - 1); // one half in fixed point representation
const uint32_t ema_start = (uint32_t) 1024 << K;  // initial state in fixed point repr
volatile uint32_t ema_filter_state[ADC_SENSOR_COUNT] = {
        ema_start, ema_start, ema_start, ema_start,
        ema_start, ema_start, ema_start, ema_start,
};

// low-pass filter threshold for heater measurements
#define LPF_MAX 2048
const uint8_t apply_lpf[ADC_SENSOR_COUNT] = {0, 0, 0, 0, 0, 1, 1, 0};

int32_t error_sum = 0;

int main(void) {
    WDTCTL = WDTPW | WDTHOLD;   // Stop watchdog timer
    message_tx.data = ADC_UNKNOWN_VALUE; // init to impossible/hard to reach value for fault detection

    initClockTo16MHz();
    initGPIO();
    initI2C();
    initADC();
    initTimer();

    __enable_interrupt(); // enable timer, I2C & ADC interrupts

    for (;;) {
        //TODO replace with timer
        ADC12CTL0 |= ADC12SC;       // Start ADC conversion, software controlled
        LPM0;                       // turn CPU off; ADC interrupt will resume
        heater_process();
    }
}

void initTimer() {
    // Configure Timer A at 1 kHz
    BCSCTL2 |= DIVS_0;                  // SMCLK: 16MHz DCO divided by 1 = 16 MHz (SLAU144K, table 5-4)
    CCR0 = 8000;                        // timer frequency: SMCLK 16 MHz / 8000 = 2 kHz
    TACCTL0 = CCIE;                     // enable A0 interrupt on CCR0 overflow
    CCR2 = 0;                           // duty cycle: CCR2 / 8000
    TACCTL2 = OUTMOD_7;                 // CCR2 reset/set mode for output
    TACTL = TASSEL_2 | MC_1 | ID_1;     // SMCLK, CCR0 up mode, input divider /2 = 1000 Hz
}

inline unsigned int update_pid(unsigned int value) {
    int error = (int) set_point - (int) value; // both inputs must be positive and <=2^12 (ADC values)
    error_sum += (error >> K_I_SHIFT);
    if (error_sum > MAX_OUT) error_sum = MAX_OUT;
    if (error_sum < MIN_OUT) error_sum = MIN_OUT;
    int out = K_P * error + ((int16_t) error_sum); // MSP430 ABI maintains sign in arithmetic right-shift
    if (out > MAX_OUT) out = MAX_OUT;
    else if (out < MIN_OUT) out = MIN_OUT;
    return (unsigned int) out; // max and min ensure conversion is safe: 0 < out < 2^15
}

unsigned int startup_led_toggles = 6;
unsigned int ta_count = 0;

// Timer A interrupt handler
#if defined(__TI_COMPILER_VERSION__) || defined(__IAR_SYSTEMS_ICC__)
#pragma vector=TIMERA0_VECTOR
__interrupt void Timer_A(void)
#elif defined(__GNUC__)

void __attribute__ ((interrupt(TIMERA0_VECTOR))) Timer_A(void)
#else
#error Compiler not supported!
#endif
{
    ta_count++;
    if (ta_count > 1000) {
        // timer A is 1 kHz, so this runs once per second
        ta_count = 0;
        if (heater_mode == HEATER_MODE_PID) {
            P5OUT ^= LED_YELLOW;     // toggle PID indicator LED
            unsigned int adc_value = adc_readings[control_sensor];
            if (adc_value >= ADC_MIN_VALUE && adc_value <= ADC_MAX_VALUE) {
                CCR2 = update_pid(adc_value);
            } else {
                CCR2 = 0;
            }
        } else {
            CCR2 = 0;
            P5OUT &= ~(LED_YELLOW); // turn off PID indicator LED
        }

        // flash startup indicator 3 times
        if (startup_led_toggles != 0) {
            P5OUT ^= LED_GREEN;
            startup_led_toggles--;
        }
    }
}

void process_cmd_tx(unsigned char cmd) {
    if (cmd >= COMMAND_READ_SENSOR_LOW && cmd <= COMMAND_READ_SENSOR_HIGH) {
        // set active adc to read from
        unsigned int sensor = cmd - COMMAND_READ_SENSOR_LOW;
        transmit_uint(adc_readings[sensor]);
    } else if (cmd >= COMMAND_READ_AVG_LOW && cmd <= COMMAND_READ_AVG_HIGH) {
        // set active adc to read from
        unsigned int sensor = cmd - COMMAND_READ_AVG_LOW;
        transmit_uint(adc_avg[sensor]);
    } else if (cmd == COMMAND_READ_BOARD_VERSION) {
        transmit_uint(HESTIA_VERSION);
    } else if (cmd == COMMAND_READ_BOARD_STATUS) {
        transmit_uint(board_status);
    } else if (cmd == COMMAND_READ_HEATER_MODE) {
        transmit_uint(heater_mode);
    } else if (cmd == COMMAND_READ_TARGET_TEMP) {
        transmit_uint(set_point);
    } else if (cmd == COMMAND_READ_TARGET_SENSOR) {
        transmit_uint(control_sensor);
    } else if (cmd == COMMAND_READ_PWM_DUTY) {
        if (heater_mode == HEATER_MODE_PID) {
            transmit_uint(CCR2);
        } else {
            transmit_uint(pwm_duty);
        }
    } else if (cmd == COMMAND_READ_MAX_TEMP) {
        transmit_uint(max_temp);
    } else {
        // Unknown command
        TransmitLen = 0;
    }
}

inline void transmit_uint(unsigned int value) {
    // Fill out the transmit buffer
    message_tx.data = value;
    TransmitLen = 2;
    CopyArray(message_tx.I2CPacket);
}

void I2C_Slave_ProcessCMD(unsigned char *message_rx, uint16_t length) {
    // make more like a read write register thing
    // need to take multiple byte sin first byte is register remaining byte is command
    // http://nilhcem.com/android-things/arduino-as-an-i2c-slave
    uint8_t cmd = message_rx[0];
    unsigned char *package = message_rx + 1; // ignore the command

    P5OUT ^= (HESTIA_VERSION < 200) ? LED_GREEN : LED_BLUE;

    if (cmd == COMMAND_WRITE_HEATER_MODE) {
        // Set the heater mode
        heater_mode = package[0];
        if (heater_mode == HEATER_MODE_PWM) {
            P1SEL &= ~HEATER_PIN;                     // P1.7 disable TA2 option
        } else if (heater_mode == HEATER_MODE_PID) {
            P1SEL |= HEATER_PIN;                      // P1.7 enable TA2 option
        }
        board_status &= ~BOARD_STATUS_MAX_TEMP;       // clear max temp flag
    } else if (cmd == COMMAND_WRITE_TARGET_TEMP) {
        if (length >= 2) {
            set_point = (package[1] << 8) + package[0];
        }
        TransmitLen = 0;
    } else if (cmd == COMMAND_WRITE_TARGET_SENSOR) {
        if (package[0] < ADC_SENSOR_COUNT) {
            control_sensor = package[0];
        }
        TransmitLen = 0;
    } else if (cmd == COMMAND_WRITE_PWM_DUTY) {
        if (package[0] <= HEATER_PWM_DUTY_MAX) {
            pwm_duty = package[0];
        }
        TransmitLen = 0;
    } else if (cmd == COMMAND_WRITE_MAX_TEMP) {
        if (length >= 2) {
            max_temp = (package[1] << 8) + package[0];
        }
        TransmitLen = 0;
    } else if (cmd == COMMAND_RESET) {
        WDTCTL = 0xDEAD;  // write to the WDT password to trigger a reset
    } else {
        // unknown command
        TransmitLen = 0;
    }
}

inline void disable_heater_max_temp() {
    heater_mode = HEATER_MODE_OFF;
    P1SEL &= ~HEATER_PIN;  // P1.7 disable TA2 option - drive heater pin manually
    P1OUT &= ~HEATER_PIN;  // set P1.7 low
    if (HESTIA_VERSION < 200) P5OUT &= ~LED_YELLOW;   // heater LED off on board v1
    board_status |= BOARD_STATUS_MAX_TEMP;
}

inline bool max_temp_exceeded() {
    return max_temp != 0 && (
            adc_readings[0] > max_temp ||
            adc_readings[1] > max_temp ||
            adc_readings[2] > max_temp ||
            adc_readings[3] > max_temp ||
            adc_readings[4] > max_temp
    );
}

inline bool is_pwm_heating_on() {
    return counter < pwm_duty;
}

void heater_process() {
    if (max_temp_exceeded()) {
        disable_heater_max_temp();
        return;
    }
    if (heater_mode == HEATER_MODE_PWM) {
        counter++;
        if (counter > HEATER_PWM_DUTY_MAX) {
            counter = 0;
        }
        if (is_pwm_heating_on()) {
            P1OUT |= HEATER_PIN;
            if (HESTIA_VERSION < 200) P5OUT |= LED_YELLOW;    // LED on
        } else {
            P1OUT &= ~HEATER_PIN;
            if (HESTIA_VERSION < 200) P5OUT &= ~LED_YELLOW;   // LED off
        }
    } else if (heater_mode == HEATER_MODE_PID) {
        // do nothing - PID timer will take care of heater pin and LEDs
    } else {
        // turn everything off
        P1OUT &= ~HEATER_PIN;
        if (HESTIA_VERSION < 200) P5OUT &= ~LED_YELLOW;   // LED off
    }
}

void initClockTo16MHz() {
    if (CALBC1_16MHZ == 0xFF) {
        while (1); // trap CPU if calibration constant not found
    }
    DCOCTL = 0;                 // Select lowest DCOx and MODx settings
    BCSCTL1 = CALBC1_16MHZ;     // Set DCO to 16 MHz
    BCSCTL2 = 0;                // Reset clock settings to defaults
    BCSCTL2 |= SELM_0;          // Set MCLK to use DCO
    DCOCTL = CALDCO_16MHZ;
}

void initGPIO() {
    // I2C Pins
    P3SEL |= BIT1 | BIT2;                     // P3.1,2 for I2C

    // Status LEDs
    P5DIR |= (LED_YELLOW | LED_GREEN | LED_BLUE);  // LED output pins
    P5OUT &= ~(LED_YELLOW | LED_GREEN | LED_BLUE); // Turn off status LEDs

    P1DIR |= HEATER_PIN;                      // P1.7 is output
    P1OUT &= ~HEATER_PIN;                     // Set heater off
    P1SEL |= HEATER_PIN;                      // P1.7 TA2 option
}

void initADC() {
    P6SEL = 0x0F;                             // Enable A/D channel inputs
    ADC12CTL0 = ADC12ON | MSC;                // Turn on ADC12, multiple sample/conv mode
    ADC12CTL0 |= SHT0_3;                      // Sample+hold time: 32 ADC12CLK cycles (6.4 us)
    ADC12CTL1 = SHP + CONSEQ_1;               // Use sampling timer, single conversion
    ADC12CTL1 |= ADC12SSEL_0;                 // Use ADC12OSC internal oscillator (~5 MHz)
    ADC12CTL1 |= ADC12DIV_0;                  // ADC12 clock divider = /1
    ADC12MCTL0 = INCH_0;                      // ref+=AVcc, channel = A0
    ADC12MCTL1 = INCH_1;                      // ref+=AVcc, channel = A1
    ADC12MCTL2 = INCH_2;                      // ref+=AVcc, channel = A2
    ADC12MCTL3 = INCH_3;                      // ref+=AVcc, channel = A3
    ADC12MCTL4 = INCH_4;                      // ref+=AVcc, channel = A4
    ADC12MCTL5 = INCH_5;                      // ref+=AVcc, channel = A5
    ADC12MCTL6 = INCH_6;                      // ref+=AVcc, channel = A6
    ADC12MCTL7 = INCH_7 + EOS;                // ref+=AVcc, channel = A7, end seq.
    ADC12IE = BIT7;                           // Enable ADC12IFG.7
    ADC12CTL0 |= ENC;                         // Enable conversions
}

/// Exponential moving average (EMA) filter
/// Updates the filter with the given input and return the filtered output.
inline uint16_t update_ema_filter(uint8_t index, uint16_t reading) {
    ema_filter_state[index] += reading;
    uint16_t output = (ema_filter_state[index] + half) >> K;
    ema_filter_state[index] -= output;
    return output;
}

// ADC12 interrupt service routine
#if defined(__TI_COMPILER_VERSION__) || defined(__IAR_SYSTEMS_ICC__)
#pragma vector=ADC12_VECTOR
__interrupt void ADC12_ISR(void)
#elif defined(__GNUC__)

void __attribute__ ((interrupt(ADC12_VECTOR))) ADC12_ISR(void)
#else
#error Compiler not supported!
#endif
{
    if (heater_mode != HEATER_MODE_PWM || is_pwm_heating_on()) {
        adc_readings[0] = ADC12MEM0;
        adc_readings[1] = ADC12MEM1;
        adc_readings[2] = ADC12MEM2;
        adc_readings[3] = ADC12MEM3;
        adc_readings[4] = ADC12MEM4;
        adc_readings[5] = ADC12MEM5;
        adc_readings[6] = ADC12MEM6;
        adc_readings[7] = ADC12MEM7;
        // IFG is cleared by reads
    } else {
        ADC12IFG = 0; // reset IFG manually when we're not reading data
    }

    __bic_SR_register_on_exit(CPUOFF);      // Clear CPUOFF bit from 0(SR)
}
