mawson-rovers/hestia/hestia-fw/main.h

#ifndef MAIN_H
#define MAIN_H

#define HESTIA_VERSION 220  // 3 digits -> major, minor, rev

// GPIO PINS
#define LED_YELLOW BIT2  // P5.2
#define LED_GREEN  BIT3  // P5.3
#define LED_BLUE   BIT4  // P5.4 - only in board version 200+
#define HEATER_PIN BIT7  // P1.7

// I2C commands
#define COMMAND_READ_SENSOR_LOW      0x01
#define COMMAND_READ_SENSOR_HIGH     0x08

#define COMMAND_READ_BOARD_VERSION   0x10
#define COMMAND_READ_BOARD_STATUS    0x11

#define COMMAND_READ_HEATER_MODE     0x20
#define COMMAND_READ_TARGET_TEMP     0x21
#define COMMAND_READ_TARGET_SENSOR   0x22
#define COMMAND_READ_PWM_DUTY        0x23
#define COMMAND_READ_MAX_TEMP        0x24

#define COMMAND_READ_AVG_LOW         0x31
#define COMMAND_READ_AVG_HIGH        0x38

#define COMMAND_WRITE_HEATER_MODE    0x40
#define COMMAND_WRITE_TARGET_TEMP    0x41
#define COMMAND_WRITE_TARGET_SENSOR  0x42
#define COMMAND_WRITE_PWM_DUTY       0x43
#define COMMAND_WRITE_MAX_TEMP       0x44

#define COMMAND_RESET                0x50

// board status
#define BOARD_STATUS_ON              BIT0
#define BOARD_STATUS_MAX_TEMP        BIT1

// heater modes
#define HEATER_MODE_OFF 0x00
#define HEATER_MODE_PID 0x01
#define HEATER_MODE_PWM 0x02

#define HEATER_PWM_DUTY_DEFAULT 255
#define HEATER_PWM_DUTY_MAX     255

// ADC
#define ADC_SENSOR_COUNT 8
#define ADC_MIN_VALUE 0x0010
#define ADC_MAX_VALUE 0x0FFF
#define ADC_UNKNOWN_VALUE 0xffff

// ADC values for TH1 - thermistor model NTCS0603E3103JMT
// source: https://www.vishay.com/en/thermistors/ntc-rt-calculator/
#define TEMP_120C 3893
#define TEMP_80C 3555
#define TEMP_70C 3397
#define TEMP_60C 3192
#define TEMP_50C 2934
#define TEMP_40C 2618
#define TEMP_25C 2048
#define TEMP_0C  1044

void initGPIO();
void initClockTo16MHz();
void initADC();
void initTimer();

void process_cmd_tx(unsigned char cmd);
void transmit_uint(unsigned int value);

void I2C_Slave_ProcessCMD(unsigned char *message, uint16_t length);
void heater_process();

#endif
