mawson-rovers/hestia/hestia-sat/src/heater.rs

use std::convert::TryFrom;
use serde::{Deserialize, Serialize};
use crate::board::BoardFlags;
use crate::reading::SensorReading;
use crate::ReadResult;
use crate::sensors::Sensor;

#[repr(u16)]
#[derive(Debug, Copy, Clone, Serialize, Deserialize, PartialEq)]
pub enum HeaterMode {
    OFF = 0x00,
    /// temperature controlled
    PID = 0x01,
    /// fixed power input
    PWM = 0x02,
}

#[repr(u16)]
#[derive(Debug, Copy, Clone, Serialize, Deserialize)]
pub enum TargetSensor {
    TH1 = 0x00,
    TH2 = 0x01,
    TH3 = 0x02,
    J7  = 0x03,
    J8  = 0x04,
}

pub trait Heater {
    fn read_mode(&self) -> ReadResult<SensorReading<HeaterMode>>;
    fn write_mode(&self, mode: HeaterMode);

    fn read_duty(&self) -> ReadResult<SensorReading<u16>>;
    fn write_duty(&self, duty: u16);

    fn read_target_temp(&self) -> ReadResult<SensorReading<f32>>;
    fn write_target_temp(&self, temp: f32);

    fn read_target_sensor(&self) -> ReadResult<SensorReading<Sensor>>;
    fn write_target_sensor(&self, target_sensor: TargetSensor);

    fn read_max_temp(&self) -> ReadResult<SensorReading<f32>>;
    fn write_max_temp(&self, temp: f32);

    fn read_version(&self) -> ReadResult<SensorReading<String>>;
    fn read_flags(&self) -> ReadResult<SensorReading<BoardFlags>>;
}

impl std::fmt::Display for HeaterMode {
    fn fmt(&self, f: &mut std::fmt::Formatter<'_>) -> std::fmt::Result {
        match self {
            HeaterMode::OFF => write!(f, "OFF"),
            HeaterMode::PID => write!(f, "PID"),
            HeaterMode::PWM => write!(f, "PWM"),
        }
    }
}

impl TryFrom<u16> for HeaterMode {
    type Error = ();

    fn try_from(v: u16) -> Result<Self, Self::Error> {
        match v {
            x if x == HeaterMode::OFF as u16 => Ok(HeaterMode::OFF),
            x if x == HeaterMode::PID as u16 => Ok(HeaterMode::PID),
            x if x == HeaterMode::PWM as u16 => Ok(HeaterMode::PWM),
            _ => Err(()),
        }
    }
}

impl From<String> for TargetSensor {
    fn from(value: String) -> Self {
        match value.to_uppercase().as_str() {
            "TH1" => TargetSensor::TH1,
            "TH2" => TargetSensor::TH2,
            "TH3" => TargetSensor::TH3,
            "J7" => TargetSensor::J7,
            "J8" => TargetSensor::J8,
            _ => panic!("Unsupported target sensor: {}", value),
        }
    }
}
