mawson-rovers/hestia/hestia-sat/src/bin/uts-web/log_data.rs

use std::collections::{HashSet, LinkedList};
use std::convert::TryInto;
use std::fs::File;
use std::io::{BufRead, BufReader};
use std::iter::zip;
use std::path::PathBuf;

use chrono::{Local, ParseError, TimeZone};
use chrono::format::{DelayedFormat, parse, Parsed};
use log::{debug, warn};
use serde::Serialize;

use uts_ws1::board;
use uts_ws1::board::BoardId;
use uts_ws1::csv::TIMESTAMP_FORMAT_ITEMS;
use uts_ws1::payload::Config;

use crate::data::{SystemTimeTempData, TimeTempData};

pub fn read_logs(config: &Config) -> SystemTimeTempData {
    if let Some(reader) = open_last_log_file(config.log_path.as_ref()) {
        process_file(reader)
    } else {
        warn!("No recent log data to return");
        SystemTimeTempData::new()
    }
}

fn process_file(reader: BufReader<File>) -> SystemTimeTempData {
    let mut lines_iter = reader.lines().map(|l|
        l.unwrap_or_else(|_| String::from("")));
    let sensor_whitelist = sensors_to_include();
    let headers: Vec<Option<&'static str>> = match lines_iter.next() {
        None => {
            warn!("Couldn't read header line from CSV file");
            return SystemTimeTempData::new();
        }
        Some(line) => {
            parse_headers(&line, &sensor_whitelist)
        }
    };

    debug!("Buffering lines");
    let mut lines_to_process: LinkedList<String> = LinkedList::new();
    let mut first_line = 2;
    for line in lines_iter {
        lines_to_process.push_back(line);
        if lines_to_process.len() > 3000 {
            lines_to_process.pop_front();
            first_line += 1;
        }
    }

    debug!("Starting processing lines");
    let mut result = SystemTimeTempData::new();
    for (index, line) in zip(first_line.., lines_to_process) {
        process_line(index, line, &headers, &mut result);
    }
    debug!("Finished processing lines");
    result
}

fn parse_headers(line: &str, sensor_whitelist: &HashSet<&'static str>) -> Vec<Option<&'static str>> {
    let mut whitelist = sensor_whitelist.clone();
    line.split(',').map(|s| {
        whitelist.take(s)   // None for headers not in the whitelist
    }).collect()
}

fn parse_timestamp(value: &str) -> Result<String, ParseError> {
    let mut parsed = Parsed::new();
    parse(&mut parsed, value, TIMESTAMP_FORMAT_ITEMS.iter())?;
    let timestamp = parsed.to_naive_datetime_with_offset(0 /* UTC */)?;
    let timestamp = Local.from_utc_datetime(&timestamp);
    let format = DelayedFormat::new(Some(timestamp.date_naive()),
                                    Some(timestamp.time()),
                                    TIMESTAMP_FORMAT_ITEMS.iter());
    Ok(format.to_string())
}

fn process_line(index: usize, line: String, headers: &Vec<Option<&'static str>>,
                result: &mut SystemTimeTempData) {
    let values: Vec<&str> = line.split(',').collect();
    debug!("Read CSV values: {:?}", values);

    let timestamp = match parse_timestamp(values[0]) {
        Ok(v) => v,
        Err(_) => {
            // don't print the bogus data, in case it corrupts the log file too
            warn!("Ignoring line {} with invalid timestamp", index);
            return;
        }
    };

    let board_id: BoardId = match values[1].try_into() {
        Ok(v) => v,
        Err(_) => {
            warn!("Ignoring line {} with invalid board_id: {}", index, values[1]);
            return;
        }
    };

    // pull out some additional data for calculated fields
    let (mut mode, mut duty) = (None::<&str>, None::<f32>);

    for i in 2..headers.len() {
        if let Some(sensor_id) = headers[i] {
            let value = values[i];
            if !value.is_empty() {
                result.add(board_id, sensor_id,
                           TimeTempData::new(&timestamp, value));
            }

            if sensor_id == "heater_mode" { mode = Some(value) }
            if sensor_id == "heater_duty" { duty = value.parse().ok() }
        }
    }

    // add derived value for heater_duty between 0.0 and 1.0, depending on mode
    match (mode, duty) {
        (Some("PID"), Some(duty)) => {
            result.add(board_id, "heater_duty",
                       TimeTempData::new_f32(&timestamp, duty / 1000.0));
        },
        (_, Some(duty)) => {
            result.add(board_id, "heater_duty",
                       TimeTempData::new_f32(&timestamp, duty / 255.0));
        },
        _ => {}
    }
}

fn sensors_to_include() -> HashSet<&'static str> {
    let mut result = HashSet::new();
    for sensor in board::ALL_SENSORS {
        result.insert(sensor.id);
    }
    result.insert("heater_voltage");
    result.insert("heater_current");
    result.insert("heater_power");
    result.insert("target_temp");
    result
}

fn open_last_log_file(log_path: Option<&String>) -> Option<BufReader<File>> {
    let log_file = get_last_log_file(log_path?)?;
    debug!("Opening last log file: {}", log_file.display());
    let file = File::open(log_file).ok()?;
    Some(BufReader::new(file))
}

fn get_last_log_file(log_path: &String) -> Option<PathBuf> {
    let pattern = format!("{}/uts-data-*[0-9].csv", log_path);
    let mut files: Vec<PathBuf> = glob::glob(pattern.as_str())
        .expect("pattern error")
        .map(Result::unwrap)
        .collect();
    files.sort();
    files.last().cloned()
}

#[derive(Debug, Clone, Serialize)]
pub struct LogFile {
    name: String,
    url: String,
}

pub(crate) fn list_logs(config: &Config) -> Vec<LogFile> {
    let pattern = format!("{}/uts-data-*.csv", config.log_path.as_ref().unwrap());
    let mut files: Vec<PathBuf> = glob::glob(pattern.as_str())
        .expect("pattern error")
        .map(Result::unwrap)
        .collect();
    files.sort();
    files.reverse();
    files.iter()
        .map(|f| {
            // Rust's filename handling is awful :(
            let name = f.file_name().unwrap().to_string_lossy().to_string();
            let name = format!("{}{}", hostname_prefix(), name);
            LogFile { name: name.clone(), url: format!("/api/log/{}", name) }
        })
        .collect()
}

fn hostname_prefix() -> String {
    hostname::get().map(|v| format!("{}-", v.to_string_lossy()))
        .unwrap_or(String::from(""))
}

pub(crate) fn get_log_file(config: &Config, name: &String) -> PathBuf {
    let prefix = hostname_prefix();
    let name = name.strip_prefix(prefix.as_str()).unwrap_or(name);
    PathBuf::from(config.log_path.as_ref().unwrap()).join(name)
}

#[cfg(test)]
mod tests {
    use std::fs::File;
    use std::io::BufReader;
    use std::path::PathBuf;
    use std::time::Instant;

    use log::info;

    use crate::data::SystemTimeTempData;
    use crate::log_data::{parse_headers, process_file, process_line, sensors_to_include};

    #[test]
    fn test_process_file() {
        let last = Instant::now();
        let _ = env_logger::try_init();
        let path = PathBuf::from("../var/logs/uts-data-2023-08-16-raw.csv");
        let file = File::open(path).unwrap();
        let reader = BufReader::new(file);
        info!("test setup took {} µs", Instant::now().duration_since(last).as_micros());
        let last = Instant::now();

        let result = process_file(reader);
        let took_micros = Instant::now().duration_since(last).as_micros();
        assert!(took_micros < 150_000, "processing took {} µs, should be less than 150 ms", took_micros);
        let last = Instant::now();

        let json = serde_json::to_string_pretty(&result).unwrap();
        let took_micros = Instant::now().duration_since(last).as_micros();
        assert!(took_micros < 100_000, "json took {} µs, should be less than 100 ms", took_micros);

        let expected_json = r#"{
  "bottom": {
    "TH1": [
      [
        "2023-08-16 14:13:37.264318",
        "1962"
      ],
      [
        "2023"#;
        assert_eq!(&json[0..120], expected_json);
    }

    #[test]
    fn test_process_line() {
        let last = Instant::now();
        let _ = env_logger::try_init();
        let headers = "UTC,board,TH1,TH2,TH3,U4,U5,U6,U7,TH4,TH5,TH6,J7,J8,J12,J13,J14,J15,J16,\
            heater_v_high,heater_v_low,heater_curr,heater_mode,target_temp,target_sensor,heater_duty";
        let headers = parse_headers(headers, &sensors_to_include());
        let line = String::from("2023-08-17 04:17:15.406834,2,24.57,25.74,24.76,25.16,24.63,25.14,\
            25.01,24.64,25.34,25.10,24.52,,,,,,,5.03,5.03,0.01,OFF,0.86,TH1,255");
        let mut result = SystemTimeTempData::new();

        info!("test setup took {} µs", Instant::now().duration_since(last).as_micros());
        let last = Instant::now();

        process_line(25, line, &headers, &mut result);
        info!("processing line took {} µs", Instant::now().duration_since(last).as_micros());
        let took_micros = Instant::now().duration_since(last).as_micros();
        assert!(took_micros < 5000, "processing took {} µs, should be less than 5000 µs", took_micros);
        let last = Instant::now();

        let json = serde_json::to_string_pretty(&result).unwrap();
        info!("json took {} µs", Instant::now().duration_since(last).as_micros());
        let took_micros = Instant::now().duration_since(last).as_micros();
        assert!(took_micros < 500, "json took {} µs, should be less than 500 µs", took_micros);

        assert_eq!(&json[0..140], r#"{
  "bottom": {
    "TH1": [
      [
        "2023-08-17 14:17:15.406834",
        "24.57"
      ]
    ],
    "TH2": [
      [
        "2023"#);
    }
}
