mawson-rovers/hestia/hestia-fw/i2c.c

#include <msp430.h>
#include <stdint.h>
#include <stdbool.h>
#include "main.h"
#include "i2c.h"

uint8_t TransmitBuffer[MAX_BUFFER_SIZE] = {0};
uint8_t TransmitIndex = 0;

unsigned char *PRxData;                     // Pointer to RX data
unsigned char RXByteCtr;
volatile unsigned char RxBuffer[128];

void CopyArray(const uint8_t *source) {
    // copy data into transmitt buffer
    //TODO disable interupt
    //TODO take sensor message
    uint8_t copyIndex = 0;
    for (copyIndex = 0; copyIndex < MAX_BUFFER_SIZE; copyIndex++) {
        TransmitBuffer[copyIndex] = source[copyIndex];
    }
    TransmitIndex = 0;
}




//******************************************************************************
// Device Initialization *******************************************************
//******************************************************************************


void initI2C() {
    UCB0CTL1 |= UCSWRST;                      // Enable SW reset
    UCB0CTL0 = UCMODE_3 + UCSYNC;             // I2C Slave, synchronous mode
    UCB0I2COA = SLAVE_ADDR;                   // Own Address
    UCB0CTL1 &= ~UCSWRST;                     // Clear SW reset, resume operation
    UCB0I2CIE |= UCSTPIE + UCSTTIE;           // Enable STT and STP interrupt
    IE2 |= UCB0RXIE | UCB0TXIE;               // Enable TX, RX interrupt
}


//******************************************************************************
// I2C Interrupt For Received and Transmitted Data******************************
//******************************************************************************
//------------------------------------------------------------------------------
// The USCI_B0 data ISR is used to move received data from the I2C master
// to the MSP430 memory.
//------------------------------------------------------------------------------

#if defined(__TI_COMPILER_VERSION__) || defined(__IAR_SYSTEMS_ICC__)
#pragma vector = USCIAB0TX_VECTOR
__interrupt void USCIAB0TX_ISR(void)
#elif defined(__GNUC__)
void __attribute__ ((interrupt(USCIAB0TX_VECTOR))) USCIAB0TX_ISR(void)
#else
#error Compiler not supported!
#endif
{
    // UCB0IV;
    if (IFG2 & UCB0RXIFG)       // Receive Data Interrupt
    {
//      P5OUT |= LED_GREEN;     // LED_1 on
//      P5OUT &= ~LED_YELLOW;   // LED_2 off
        // I2C slave
        *PRxData++ = UCB0RXBUF; // Move RX data to address PRxData
        if (RXByteCtr == 0) {     // first byte
            process_cmd_tx(UCB0RXBUF);
        }
        RXByteCtr++;                              // Increment RX byte count
    } else if (IFG2 & UCB0TXIFG)            // Transmit Data Interrupt
    {
//      P5OUT |= LED_YELLOW;                          // LED_2 on
//      P5OUT &= ~LED_GREEN;                         // LED_1 off
        //Must write to UCB0TXBUF
        TransmitLen = 2;
        if ((TransmitIndex < TransmitLen) && TransmitIndex < MAX_BUFFER_SIZE) {
            UCB0TXBUF = TransmitBuffer[TransmitIndex++];
        } else {
            UCB0TXBUF = 0; // Out of range
        }
    }
}



//******************************************************************************
// I2C Interrupt For Start, Restart, Nack, Stop ********************************
//******************************************************************************

#if defined(__TI_COMPILER_VERSION__) || defined(__IAR_SYSTEMS_ICC__)
#pragma vector = USCIAB0RX_VECTOR
__interrupt void USCIAB0RX_ISR(void)
#elif defined(__GNUC__)
void __attribute__ ((interrupt(USCIAB0RX_VECTOR))) USCIAB0RX_ISR(void)
#else
#error Compiler not supported!
#endif
{
    if (UCB0STAT & UCSTPIFG)                        //Stop or NACK Interrupt
    {
//        P5OUT |= LED_YELLOW;                          // Yellow LED on
//        P5OUT &= ~LED_GREEN;                          // Green LED off
        PRxData = (unsigned char *) RxBuffer;
        I2C_Slave_ProcessCMD(PRxData, RXByteCtr);
        RXByteCtr = 0;
        if (UCB0STAT) {
            TransmitIndex = 0;
        }
        UCB0STAT &=
            ~(UCSTTIFG + UCSTPIFG + UCNACKIFG);     //Clear START/STOP/NACK Flags
        __bic_SR_register_on_exit(CPUOFF);      // Exit LPM0 if data was
    }
    if (UCB0STAT & UCSTTIFG)                        //Start Interrupt???
    {
//        P5OUT |= LED_YELLOW;                          // Yellow LED on
//        P5OUT |= LED_GREEN;                           // Green LED on
        UCB0STAT &= ~(UCSTTIFG);                    //Clear START Flags
        TransmitIndex = 0;
        // clear the rx buffer
        RXByteCtr = 0;
        PRxData = (unsigned char *) RxBuffer;
    }
}
