mawson-rovers/hestia/hestia-dash/src/hestia/board.py

import logging
import os
from collections import OrderedDict
from typing import Dict

from hestia import heater
from hestia.heater import HeaterMode
from hestia.i2c import i2c_write_int
from hestia.sensors import Sensor, SensorInterface

logger = logging.getLogger('hestia.board')

SENSOR_DISABLE_ENV_VAR = 'HESTIA_SENSOR_DISABLE'

MSP430_I2C_ADDR = 0x08
MSP430_COMMAND_RESET = 0x50

_sensors = [
    Sensor("TH1", SensorInterface.MSP430, 0x01, "Centre", -42.0135, 43.18),
    Sensor("TH2", SensorInterface.MSP430, 0x02, "Top-left of heater", -35.7124, 54.61),
    Sensor("TH3", SensorInterface.MSP430, 0x03, "Bottom-right of heater", -53.88, 33.496),

    Sensor("U4", SensorInterface.MAX31725, 0x48, "Top-left", -15.976, 75.225),
    Sensor("U5", SensorInterface.MAX31725, 0x4F, "Top-right", 81.788, 75.692),
    Sensor("U6", SensorInterface.MAX31725, 0x49, "Bottom-right", -82.296, 12.8535),
    Sensor("U7", SensorInterface.MAX31725, 0x4B, "Centre", 46.228, 47.752),

    Sensor("TH4", SensorInterface.ADS7828, 0x00, "Centre", -45.8705, 43.18),
    Sensor("TH5", SensorInterface.ADS7828, 0x01, "Top-right", -77.9814, 75.0769),
    Sensor("TH6", SensorInterface.ADS7828, 0x02, "Bottom-left of heater", 33.274, 30.226),

    Sensor("J7", SensorInterface.MSP430, 0x04, "Mounted"),
    Sensor("J8", SensorInterface.MSP430, 0x05, "Mounted"),
    Sensor("J9", SensorInterface.RAW, 0x06, "Mounted"),
    Sensor("J10", SensorInterface.RAW, 0x07, "Mounted"),
    Sensor("J11", SensorInterface.RAW, 0x08, "Mounted"),

    Sensor("J12", SensorInterface.ADS7828, 0x03, "Mounted"),
    Sensor("J13", SensorInterface.ADS7828, 0x04, "Mounted"),
    Sensor("J14", SensorInterface.ADS7828, 0x05, "Mounted"),
    Sensor("J15", SensorInterface.ADS7828, 0x06, "Mounted"),
    Sensor("J16", SensorInterface.ADS7828, 0x07, "Mounted"),
]


# noinspection PyMethodMayBeStatic
class Hestia:
    def __init__(self) -> None:
        super().__init__()
        self.sensors = _sensors
        if SENSOR_DISABLE_ENV_VAR in os.environ:
            disabled_sensors = os.environ[SENSOR_DISABLE_ENV_VAR].casefold().split(',')
            logger.info('Disabling sensors per configuration: %s' % disabled_sensors)
            self.sensors = [s for s in self.sensors if s.id.casefold() not in disabled_sensors]
        self.center_sensor = self.sensors[0]

    def read_center_temp(self) -> float:
        return self.center_sensor.read_temp()

    def read_sensor_values(self) -> Dict[Sensor, float]:
        return OrderedDict((s, s.read_temp()) for s in self.sensors)

    def get_heater_mode(self) -> HeaterMode:
        return heater.get_heater_mode()

    def get_heater_power_level(self) -> int:
        return heater.get_heater_power_level()

    def set_heater_pwm(self, power_level: int):
        heater.set_heater_power_level(power_level)

    def get_target_temp(self):
        return heater.get_target_temp()

    def set_target_temp(self, temp: float):
        heater.set_heater_target_temp(temp)

    def set_heater_mode(self, mode: HeaterMode):
        heater.set_heater_mode(mode);

    def reset(self):
        logger.info("Sending reset command")
        i2c_write_int(MSP430_I2C_ADDR, MSP430_COMMAND_RESET, 0, byteorder="little")
