mawson-rovers/hestia/(commit log)

2022-05-03 initial commit of empty kicad project
    [hestia.kicad_pcb, hestia.kicad_sch]
2022-05-03 intial commit of script to generate heater track
2022-05-03 Rough PC104 edgecuts outline added to hestia brd
    [hestia.kicad_pcb]
2022-05-07 added radiused corners&pad holes to PC104 outline
    [hestia.kicad_pcb]
2022-05-08 added netlist. added PC104 connector
    [hestia.kicad_pcb, hestia.kicad_sch]
2022-05-09 added function to calculate resistance
2022-05-09 added picoblade connectors
    [hestia.kicad_sch]
2022-05-09 added generic mosfet and a few capacitors
    [hestia.kicad_sch]
2022-05-09 added MSP430F2618TPN sch symbol to schematic
    [hestia.kicad_sch]
2022-05-09 updated netlist and import to pcb
    [hestia.kicad_pcb, hestia.kicad_sch]
2022-05-09 added the buck converter
    [hestia.kicad_sch]
2022-05-10 started adding support circuitry for the msp430
    [hestia.kicad_sch]
2022-05-10 added hopefully more readable symbol
    [hestia.kicad_sch]
2022-05-11 added sipeed jtag dongle
    [hestia.kicad_sch]
2022-05-12 Update gitignore to restore lib/ directory and ignore KiCAD backups and caches
2022-05-14 added place holder heater track
    [hestia.kicad_pcb]
2022-05-15 added led and io names
    [hestia.kicad_sch]
2022-05-15 added i2c adc
    [hestia.kicad_sch]
2022-05-15 added a few i2c temprature sensors
    [hestia.kicad_sch]
2022-05-15 added a few smd thermistors
    [hestia.kicad_sch]
2022-05-15 connected AVSS to capacitor #TODO fix footprint
    [hestia.kicad_sch]
2022-05-15 imported a few more componetns
    [hestia.kicad_pcb]
2022-05-15 moved pc104 (2x (2x26)) conn to correct coords on pcb
    [hestia.kicad_pcb]
2022-05-15 add gnd to TPS62091, add alt edge cut to pcb according to pumpkin recommendation, trying place uC for fit on PCB, move picoblade sockets on PCB
    [hestia.kicad_pcb, hestia.kicad_sch]
2022-05-15 corected 0.1uf capacitor to 2.2uf on LTC2309 VREF line
    [hestia.kicad_sch]
2022-05-15 grouped heat pad and rotated it
    [hestia.kicad_pcb]
2022-05-16 added pico lock connectors
    [hestia.kicad_sch]
2022-05-16 made the heatersmaller
    [hestia.kicad_pcb]
2022-05-16 updated jtag connector for JTAG HS3
    [hestia.kicad_sch]
2022-05-16 added mounting holes
    [hestia.kicad_sch]
2022-05-17 actually made the heat pad smaller
    [hestia.kicad_pcb]
2022-05-18 moved i2c adc to ADS7828 as it is in stock
    [hestia.kicad_sch]
2022-05-19 swaped out i2c temprature sensors and added logic level converter
    [hestia.kicad_sch]
2022-05-19 added a few easy ferite beads
    [hestia.kicad_sch]
2022-05-21 swaped out i2c temprature sensor for MAX31725 as in stock and better acuuracy need to verify footprint
    [hestia.kicad_sch]
2022-05-21 started placement
    [hestia.kicad_pcb]
2022-05-21 started routing
    [hestia.kicad_pcb, hestia.kicad_sch]
2022-05-21 Ignore KiCad local project settings file
2022-05-21 Add UTS logo footprint to library
2022-05-21 Add UTS logo to front silkscreen, project name and version to back
    [hestia.kicad_pcb]
2022-05-21 Add some renders of the board design as of today
2022-05-22 moved temprature connectors to edge of board
    [hestia.kicad_pcb]
2022-05-23 Add documents from Patrick Oppel (CUAVA): STEP file for the 6U structure, with some dummy payloads/PCBs + the ICD with the 2D PCB drawings with all the dimensions and proper error margins on the holes
    [tcs-6u-main-asm-example.stp]
2022-05-23 add LM2655MTC33 regulator to lib
2022-05-23 schematic: change TPS62091 to LM2655MTC33
    [hestia.kicad_sch]
2022-05-23 bit more routing
    [hestia.kicad_pcb]
2022-05-23 fixed wrong voltage for adc 2 connectors
    [hestia.kicad_sch]
2022-05-23 started routing i2c
    [hestia.kicad_pcb]
2022-05-23 add 10uH inductor. add schottky diode for buck reg, fix PCB moutline
    [hestia.kicad_pcb, hestia.kicad_sch]
2022-05-24 did last of power and i2c routing
    [hestia.kicad_pcb]
2022-05-24 cleaned up silkscreen a little
    [hestia.kicad_pcb]
2022-05-28 buck converted routed
    [hestia.kicad_pcb, hestia.kicad_sch]
2022-05-29 settle on mosfet model, swap sides of mosfet, shift regulator, widen power traces, ground stitching, add serial buffer -todo: still needs operate enble signal, add test points for i2c.
    [hestia.kicad_pcb, hestia.kicad_sch]
2022-05-29 add uart translator operate enable signal, move & rerrange component designators, add testpoint for GND
    [hestia.kicad_pcb, hestia.kicad_sch]
2022-05-29 added filter caps on uC analog thermistor circuits. added chipbeads on supply feed to uC analog thermistor circuits
    [hestia.kicad_pcb, hestia.kicad_sch]
2022-05-29 fix and cleared all Design Rule Check (DRC) errors. There are still warnings but mostly minor
    [hestia.kicad_pcb]
2022-05-29 move FB4,C17 designators
    [hestia.kicad_pcb]
2022-05-30 Move schematic generation before renders, add pre-checks (commented out for now)
2022-05-30 Put schematic in the right place
2022-05-30 Ignore kicad backup files
2022-05-30 Ensure KICAD6_3DMODEL_DIR is set to something
2022-05-30 Run DRC and ERC checks with existing errors ignored (but still logged)
    [hestia.kibot.yml]
2022-05-31 Basic temperature monitoring python code for PocketBeagle and MCP9808 via I2C
2022-06-03 add connections for indicator LEDs from uC
    [hestia.kicad_pcb, hestia.kicad_sch]
2022-06-03 connect uC vref+ to AVCC after chipbead. clear warning drc list
    [hestia.kicad_pcb, hestia.kicad_sch]
2022-06-06 change jtag connect to 2x7 2.00mm per jtag-hs3, add gnd connection to max31725MTA exposed pad
    [hestia.kicad_pcb, hestia.kicad_sch]
2022-06-06 Bumped version to 1.1, set project metadata
    - Added project name, version and date as metadata to schematic and PCB
    - Used metadata variables in silkscreen on PCB
    - Bumped version to 1.1 and date to today, as we've just sent off the 1.0
    boards for manufacturing
    - Some automatic footprint updates also included, which were due to JD's last
    change.
    [hestia.kicad_pcb, hestia.kicad_sch]
2022-06-06 moved some components to new sheets so that they are not off the page. Hopefully didn't break to much
    [PC104.kicad_sch, buck_converter.kicad_sch, hestia.kicad_sch, thermistors.kicad_sch]
2022-06-06 edit some component values
    [PC104.kicad_sch, buck_converter.kicad_sch, hestia.kicad_sch, thermistors.kicad_sch]
2022-06-21 Fill zones on PCB
2022-06-21 Use build dates on output files, not schematic date
2022-07-14 Use fixed KiCad docker image for consistent results
2022-07-14 Terminate pin 12 (LDR) on LM2655 to fix ERC warning
    [PC104.kicad_sch, buck_converter.kicad_sch, hestia.kicad_pcb, hestia.kicad_sch, thermistors.kicad_sch]
2022-07-14 Bump version to 2.0, add title to all schematic pages
    [PC104.kicad_sch, buck_converter.kicad_sch, hestia.kicad_pcb, hestia.kicad_sch, thermistors.kicad_sch]
2022-07-14 Bring back DRC exclusions accidentally removed in e587a85a
    [hestia.kicad_pcb]
2022-07-25 intial comit of some code to read adc values and send them over i2c
2022-07-30 corrected SCL SDA direction on adc, connected i2c temprature sensors to 3.3 logic
    [hestia.kicad_sch]
2022-07-30 updater thermistor to 3.3v supply
    [thermistors.kicad_sch]
2022-07-30 corrected diode placement
    [buck_converter.kicad_sch]
2022-07-30 correct C35 capcitor placement
    [buck_converter.kicad_sch]
2022-07-30 actually removed the crystal placement this time
    [hestia.kicad_sch]
2022-08-22 Move active sensor logic to I2C handler, fix spelling in a few places
    [i2c.h, main.c]
2022-08-22 Add MSP ADC temperature conversion
2022-08-23 Add some debug logging to I2C flow (commented out)
2022-08-23 Add error handling and logging, some jitter on callback timing
2022-09-05 added symbol and foot print for B2B-ZR 1.5mm shrouded pin header connector
2022-09-05 don't update pcb from schematic yet. added and changed footprint info on schematic for 1.5mm pitch term pads, crystals, jtag vcc jumper. a bunch of components are out of sync with the pcb, the schema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
    [buck_converter.kicad_sch, hestia.kicad_pcb, hestia.kicad_sch, thermistors.kicad_sch]
2022-09-06 quick hack to fix adc response coming a request late
    [i2c.c, main.c, main.h]
2022-09-10 Sorted out checmatic <=> pcb update sync. Changed JTAG pinheader to shrouded IDC connector footprint. temp place 2 pin 1.5mm pitch pin sockets. remove i2c voltage translator transistors, changed to i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
    [hestia.kicad_pcb, hestia.kicad_sch, thermistors.kicad_sch]
2022-09-11 added wire restraint holes for thermistors. Moved picolock connectors up by 3mm
    [hestia.kicad_pcb, hestia.kicad_sch]
2022-09-11 start adding mcp6N11 component library for instrumentation amplifier for current shunt
2022-09-18 disabling LED to debug PWM
2022-09-18 bit banged pwm fixed io pinout
    [main.c, main.h]
2022-10-07 hestia-i2c: a new lightweight payload control interface
    - ported over the sensor config and I2C logic
    - added two rudimentary I2C integration tests
    - build configuration so pytest runs at the command line
2022-10-07 msp430: return error values for low values on ADC lines
    [main.c, main.h]
2022-10-07 hestia-i2c: tests now work with latest MSP430 code
2022-10-07 msp430: ensure heater can still turn on when disabled by default
2022-10-07 hestia-i2c: test for heater increasing temperature ... it works!
2022-10-07 msp430: simplify heating logic a bit, make default PWM value a constant
2022-10-07 hestia-i2c: add test for full-power heating (unfortunately it makes sensor tests fail - need to sort this out)
    [heater.py]
2022-10-08 hestia-i2c: start a simple flask-based REST API
    - app.py: Flask code, just one page so far
    - board.py: Hestia, new board interface
    - stub_board.py: stub impl for use with web dev
    - move most of the config for the board into board.py
    - make sensor tests more lenient so they pass after heater tests
2022-10-10 hestia-i2c: add logging utility which writes sensor temps to CSV
2022-10-10 hestia-i2c: move heater control into Hestia class
2022-10-14 hestia-i2c: better logging for testing
2022-10-14 hestia-i2c: fix logger so it starts a new file when a day ticks over
    [logger.py]
2022-10-14 hestia-i2c: IDE config updates
2022-10-15 small anount of pcb trace changes
    [hestia.kicad_pcb]
2022-10-16 more PCB trace changes on jtag, picolock connectors, i2c translator and I2C SDA,SCL, LEDs, Reset Switch
    [hestia.kicad_pcb, hestia.kicad_sch, thermistors.kicad_sch]
2022-10-24 hestia-i2c: human readable timestamp
2022-10-24 hestia-i2c: move logging into heater code, so all heating gets logging
2022-10-24 hestia-i2c: add support for ADS7828 sensor reading with some unit tests
2022-10-24 hestia-i2c: integrate ADS7282 sensor reading into temperature reading and Hestia board interface
2022-10-25 hestia-i2c: tests for ADC conversion calculation
2022-10-25 hestia-i2c: add systemd service config for running hestia-logger automatically
2022-10-25 fix up some jtag traces. move led resstors. reroute led traces. Give wider clearance for traces around H1
    [hestia.kicad_pcb]
2022-10-27 fix wire restraint holes including hole footprint in librarythen near U3 ADC and some traces near U3
    [hestia.kicad_pcb]
2022-10-28 add ferrite chipbeads to u3. add capacitor to u3 adc ref. add capacitor to u3 thermistor input top side 3.3V supply side of resistor divider.
    [hestia.kicad_pcb, hestia.kicad_sch, thermistors.kicad_sch]
2022-10-29 hestia-i2c: add API for log files, move API root to /api, and put basic HTML home page on /
2022-10-30 Disable DRC & ERC until v2 board design is complete
2022-10-30 Update date
    [hestia.kicad_pcb]
2022-10-31 added comand to read back PWM value
2022-10-31 pcb: Add SVG logos for inclusion in v2 silkscreen
2022-11-01 hestia-i2c: fix two bugs in logger
    - change usage of sensors() method that no longer exists
    - ticking over month now correctly rotates log file
    [logger.py]
2022-11-01 hestia-i2c: fix usage of sensors() method in stub board
    [stub_board.py]
2022-11-01 hestia-i2c: add placeholders for current and voltage that will be exposed eventually
2022-11-01 hestia-i2c: move Sensor class and temp reading logic to sensors.py so board.py is simpler
2022-11-06 add another indicator led. add heater indicator led. add chipbeads to u3 adc input circuits. widen 3.3V trace to accomodate routing for adc and i2c sensors that were on 5V VCC previosuly. untangled m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
    [buck_converter.kicad_sch, hestia.kicad_pcb, hestia.kicad_sch, thermistors.kicad_sch]
2022-11-07 Rearrange traces above microcontroller to make room for wired temperature sensor restraint holes
    [hestia.kicad_pcb]
2022-11-09 Change U3 (ADS7828) i2c address to 0x4A. U4 to U7 addresses remain unchanged (U4 = 0x48, U5 = 0x4F, U6 = 0x49, U7 = 0x4B). fix up 3.3v trace and other traces above uC
    [hestia.kicad_pcb, hestia.kicad_sch]
2022-11-14 pcb: STEP file export updated projet config
2022-11-14 hestia-i2c: deployment config
2022-11-22 msp430: Add read heater mode command
    - add COMMAND_READ_HEATER_MODE
    - rename command constants to clarify read/write
    - reformat code to K&R
    - portability fixes for gcc (CLion)
    [i2c.c, main.c, main.h]
2022-11-28 adjust and rearrange top side silkscreen designators and some on the bottoms side
    [hestia.kicad_pcb]
2022-11-30 hestia-i2c: add functions to read heater status and tests to verify
2022-11-30 hestia-i2c: quieter logging from ADC reads
2022-11-30 msp430: implement reset command
    [main.c]
2022-11-30 hestia-i2c: test reset command
    [board.py]
2022-12-01 hestia-i2c: fix stub implementations for heating methods so local dev works
    [app.py, board.py, stub_board.py]
2022-12-01 hestia-i2c: add /api/recent data API
2022-12-01 hestia-i2c: round temperatures to 4dp
2022-12-01 hestia-i2c: add data APIs
2022-12-02 hestia-i2c: add basic chart and heater control to webapp
2022-12-04 hestia-i2c: fix chart type
2022-12-04 adjusted more silkscreen designators mostly on the bottom side
    [hestia.kicad_pcb]
2022-12-04 hestia-i2c: commit hestia-app service config
2022-12-04 hestia-i2c: toggle heater and adjust power level from web interface
2022-12-04 hestia-i2c: show 30 mins of data instead of 10
2022-12-05 hestia-i2c: add favicon
2022-12-05 hestia-i2c: update status info regularly
2022-12-05 hestia-i2c: enable gzip compression to speed up log_data request
2022-12-05 hestia-i2c: restyle with Milligram
2022-12-09 hestia-i2c: log heater level
2022-12-09 hestia-i2c: show heater on chart as filled area, add duration setting
2022-12-09 hestia-i2c: more realistic test data
2022-12-09 hestia-i2c: add sensor positions from current PCB design
2022-12-09 hestia-i2c: maintain sensor order in JSON responses
2022-12-09 hestia-i2c: add board status display with sensor locations & temperatures
2022-12-09 hestia-i2c: better ordering of some APIs
2022-12-09 hestia-i2c: consistent sensor colors across the page
2022-12-12 hestia-i2c: run services as debian user
2022-12-19 hestia-i2c: handle missing heater data in hybrid log file
    [app.py]
2022-12-19 hestia-i2c: improve error handling to avoid logger failing
    [heater.py, logger.py]
2023-01-15 added ina826 current sense & amp circuit to schematic
    [hestia.kicad_sch]
2023-01-17 added footprints for ina826 current sense amp support to pcb. added current sense resistor to hestia part library. added vref test point to i2c adc
    [hestia.kicad_pcb, hestia.kicad_sch]
2023-01-18 hestia-i2c: move sensor test to test_sensors.py
2023-01-18 hestia-i2c: add min value filtering for ADC values (MSP430 does this internally, but not ADS7828)
2023-01-18 hestia-i2c: add env var to disable sensors for running tests and the webapp
2023-01-18 hestia-i2c: PyCharm deployment config tweaks
2023-01-18 connected up opamp output and Vsense high and low
    [hestia.kicad_sch]
2023-01-18 routed signals, add no go zone and moved to 4 layers for routing difficulties
    [hestia.kicad_pcb]
2023-01-18 removed no longer used thermisters
    [thermistors.kicad_sch]
2023-01-18 updated logos
    [hestia.kicad_pcb]
2023-01-18 corrected typo
    [buck_converter.kicad_sch]
2023-01-18 added some comments
    [hestia.kicad_sch]
2023-01-19 added clamp diodes to voltage / current sense and connector for bimatalic switch
    [hestia.kicad_sch]
2023-01-19 added new compoenents
    [hestia.kicad_pcb]
2023-01-19 added to TODO to pick diode and updated comments
    [hestia.kicad_sch]
2023-01-22 hestia-i2c: change chart duration option from 10 to 120 min
2023-01-22 hestia-i2c: fix chart duration glitch
2023-01-22 hestia-i2c: generate stub board data for chart
2023-01-22 hestia-i2c: remove .idea/deployment.xml
2023-01-22 hestia-i2c: switch to Luxon instead of date-fns to fix JS console error
2023-01-30 Add internal layers to PDF and PCBWay gerbers output
2023-01-30 Add debug switch to Kibot Mac script
2023-01-30 Update PCBWay BOM to match template
2023-01-30 removed heater trace voltage sense high, low and current zeners. Added BAT54S diode pair to current sense amp output. TODO: FB13 needs to be rerouted to actual 5V input VCC i think.
    [hestia.kicad_pcb, hestia.kicad_sch]
2023-01-31 pcb: add Manufacturer and Type fields for PCBWay BOM
    [buck_converter.kicad_sch, thermistors.kicad_sch]
2023-01-31 pcb: add PCBWay Kibot config file for testing (not used by build)
2023-01-31 pcb: move around designators
    [hestia.kicad_pcb]
2023-01-31 pcb: fix heater low net by adding heater component, move heater and associated components to a new sheet. Some routing still to do.
    [heater.kicad_sch, hestia.kicad_pcb, hestia.kicad_sch]
2023-01-31 change trace names to match new schematic page nets heatr high and low. add vcc trace for fb13 power into current sense amp. move some silkscreen designators according to drc violation. remove some p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
    [hestia.kicad_pcb]
2023-01-31 pcb: lots of schematic cleanup, board not yet updated
    [heater.kicad_sch, hestia.kicad_sch]
2023-02-01 pcb: more cleanup on heater schematic
    [heater.kicad_sch]
2023-02-01 pcb: fix routing and remaining DRC violations, replace teardrop trace with fill zone, move J7 & J8 over a fraction
    [hestia.kicad_pcb]
2023-02-01 pcb: add heater net-tie to resolve net problems, move voltage divider out from under heater, fixed traces going into H2 courtyard, restored D1 LED designator, silkscreen updates. Didn't get Pico-Lock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
    [heater.kicad_sch, hestia.kicad_pcb, hestia.kicad_sch]
2023-02-05 changed PicoLock connector symbol and footprint. Added via stitching to PicoLock mechanical pads through to other layers
    [hestia.kicad_pcb, hestia.kicad_sch]
2023-02-05 thicken part of heater high/VCC trace, reroute traces near r44
    [hestia.kicad_pcb]
2023-02-06 add footprint library
2023-02-06 pcb: update date
    [hestia.kicad_pcb]
2023-02-06 pcb: move C8 to buck_converter schematic, removed some outdated comments
    [buck_converter.kicad_sch, heater.kicad_sch, hestia.kicad_sch]
2023-02-06 pcb: more schematic tidy up (checked and no PCB impact)
    [buck_converter.kicad_sch, hestia.kicad_sch]
2023-02-12 added some digikey and mouser part numbers to schematic parts
    [PC104.kicad_sch, buck_converter.kicad_sch, heater.kicad_sch, hestia.kicad_sch, thermistors.kicad_sch]
2023-02-13 added more digikey part numbers to schematic
    [PC104.kicad_sch, buck_converter.kicad_sch, heater.kicad_sch, hestia.kicad_sch, thermistors.kicad_sch]
2023-02-27 Restore lost footprints in schematics
    [PC104.kicad_sch, buck_converter.kicad_sch, heater.kicad_sch, hestia.kicad_sch, thermistors.kicad_sch]
2023-02-27 pcb: disable undervoltage latch on 3.3V regulator
    - replace C3 with 0R to connect LDELAY to GND
    - update footprint on PCB
    - fixes #18, fixes #25
    [buck_converter.kicad_sch, heater.kicad_sch, hestia.kicad_pcb, hestia.kicad_sch, thermistors.kicad_sch]
2023-03-05 change Y2 to 14.7456MHz because 7.3728MHz would have required the bigger size crystal pad. chose xtal load cap 12.5pf and 12pf for xtals. chose 20pf ext load caps to suit for C11,C12,C13,C14. Change 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
    [PC104.kicad_sch, buck_converter.kicad_sch, heater.kicad_sch, hestia.kicad_sch, thermistors.kicad_sch]
2023-03-06 Fix ERC ignores again
    [hestia.kibot.yml]
2023-03-06 Fix some ERC violations
    [PC104.kicad_sch, buck_converter.kicad_sch, heater.kicad_sch, hestia.kicad_sch, thermistors.kicad_sch]
2023-03-06 Remove mounting holes from BOM
    [hestia.kicad_sch]
2023-03-06 Update PCB nets from schematic, adjust silkscreen logos
    [hestia.kicad_pcb]
2023-03-06 Remove some silkscreen refs
    [buck_converter.kicad_sch, heater.kicad_sch, hestia.kicad_pcb, hestia.kicad_sch]
2023-03-07 changed all 10K to 0.5% to be same component. changed led part numbers back to 0805. - my mistake. i had thought the footprints had changed to 0603. filled in other missing digikey part numbers. adde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
    [PC104.kicad_sch, buck_converter.kicad_sch, heater.kicad_sch, hestia.kicad_pcb, hestia.kicad_sch, thermistors.kicad_sch]
2023-03-07 c39 digikey and mfr part numbers changed to a 100pf part number. It had previously erroneously been given a 10pf part number
    [PC104.kicad_sch, buck_converter.kicad_sch, heater.kicad_sch, hestia.kicad_sch]
2023-03-08 change d6? to SK34A-LTP with a DO-214AC (SMA) footprint. This diode is a higher profile and may violate height restrictions for some close stacked payload configurations.
    [PC104.kicad_sch, buck_converter.kicad_sch, heater.kicad_sch, hestia.kicad_pcb, hestia.kicad_sch, thermistors.kicad_sch]
2023-03-08 exclude J3,J4 from BOM -the pc104 pin sockets. exclude J7,J8,J12,J13,J14,J15,J16 from BOM - the shrouded pin header components for thermistors but we'll probably solder and goop leaded thermistors to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
    [PC104.kicad_sch, thermistors.kicad_sch]
2023-03-08 Include Mfg part number in PCBWay BOM
2023-03-09 hestia-i2c: include sensor type in debug logging
2023-03-09 Commit position CSV files used to determine sensor location
    [hestia-bottom-pos.csv, hestia-top-pos.csv]
2023-03-09 Move PCB into new structure
    [PC104.kicad_sch, buck_converter.kicad_sch, heater.kicad_sch, hestia.kicad_pcb, hestia.kicad_sch, thermistors.kicad_sch]
2023-03-09 Move remaining software modules to top level
    [hestia-bottom-pos.csv, hestia-top-pos.csv]
2023-03-10 hestia-pcb: fix paths in kibot build
2023-03-10 pcb: fix stackup to match PCBWay 1.6mm 1/1oz
    source: https://www.pcbway.com/multi-layer-laminated-structure.html
    [hestia.kicad_pcb]
2023-03-14 added part change to TH1-TH6. Had to change wire restraint footprint. pcbway sent a message to say it was causing a problem
    [hestia.kicad_pcb, hestia.kicad_sch, thermistors.kicad_sch]
2023-03-29 hestia-sat: log rather than panicking when errors are returned
    [main.rs]
2023-04-05 hestia-fw: add timer and PID loop
2023-04-05 hestia-sat: replace ByteOrder generics with simpler function names
    [heater.rs, i2c.rs, sensors.rs]
2023-04-09 hestia-sat: log both I2C buses and temp/raw data
2023-04-09 hestia-sat: fix parsing of UTS_I2C_BUS env var
    [config.rs]
2023-04-11 hestia-dash: add PID heater mode
2023-04-11 hestia-fw: fix write target temp logic
    [main.c]
2023-04-11 hestia-dash: add thermostat controls to dashboard
    - fix issue where new sensors weren't labelled correctly on chart
    - fix power level to duty cycle calc
    - restyle buttons
    [app.py, board.py, heater.py, sensors.py]
2023-04-11 hestia-pcb: refilled zones with gerber export
    [hestia.kicad_pcb]
2023-05-19 hestia-dash: remove circular imports in stub board
2023-05-19 hestia-dash: update ADS7878 I2C addr for new board version
2023-05-19 hestia-dash: quick hacky raw interface for voltage & current reading
2023-05-19 hestia-fw: add support for board v2
    - update LED pins
    - flash blue LED on I2C command received
2023-05-19 hestia-fw: fix line endings in main.c
    [main.c]
2023-05-29 hestia-sat: better CSV logging, more error handling
    [board.rs, config.rs, csv.rs, i2c.rs, lib.rs, main.rs, sensors.rs]
2023-05-29 hestia-sat: update ADS7828 sensor address for board v2
2023-05-29 hestia-sat: fix output order to match headers
    [main.rs]
2023-05-29 hestia-sat: default check sensor U4
2023-05-31 hestia-sat: add uts-ctl CLI, lots of logging fixes, add voltage calculations
    [board.rs, config.rs, csv.rs, heater.rs, lib.rs, logger.rs, main.rs, sensors.rs]
2023-05-31 hestia-sat: update uart-rs dependency to match new naming convention
2023-06-01 #30: hestia-sat: current sense calc
2023-06-01 #30: hestia-fw: remove range check on raw ADC reads, as current is often close to zero
    - confirmed range check still done for PID control sensor
    - confirmed range check done in client code for MSP430 temperature sensors
2023-06-01 #30: hestia-sat: change check sensor to U7, which is more central
2023-06-01 #30: hestia-sat: add heater control to uts-ctl
2023-06-01 #30: hestia-fw: add bounds checking for ADC control sensor ID
2023-06-01 #30: hestia-sat: rename package to uts_ws1 and CLI to uts-cli
    - add CLI for setting target sensor
    - change status temp to target sensor
2023-06-01 #30: hestia-sat: add target sensor to status output
2023-06-01 #30: hestia-sat: add set duty cycle to CLI, show target sensor name in display output
2023-06-01 #30: hestia-sat: better ordering of voltage/current values in log
2023-06-01 #30: hestia-sat: introduced Heater trait and Msp430 struct to simplify code
2023-06-02 #30: hestia-sat: tidy up I2C access code
2023-06-02 #30: hestia-sat: centralise logging into new wrapper around I2cDevice
2023-06-03 #30: hestia-sat: types for each device that wrap around the I2C interface
2023-06-03 #30: hestia-sat: read voltage and current sensors in the sensor loop
2023-06-03 #30: hestia-sat: fix logging inconsistency
    [i2c.rs]
2023-06-05 Updated Hestia Schematic and PCB layout to Kicad 7.05 file format. Hestia.kicad_sym file also opened and resaved.
    [PC104.kicad_sch, buck_converter.kicad_sch, heater.kicad_sch, hestia.kicad_pcb, hestia.kicad_sch, thermistors.kicad_sch]
2023-06-05 No change probably. ran drc after last save
    [hestia.kicad_pcb]
2023-06-06 #30: hestia-sat: fix inconsistent logging
    [i2c.rs]
2023-06-06 #30: hestia-sat: switch SensorReading to return a SensorDisplayValue enum, so we can use it for non-temp sensors
2023-06-06 #31: fix PWM heating
    - hestia-fw: reset P1SEL when heater mode changes
    [main.c]
2023-06-10 #30: set default PWM duty cycle to 255
2023-06-10 #30: return actual PWM value when in PID heater mode
2023-06-10 #30: rename CsvDataProvider -> BoardDataProvider
2023-06-11 #30: add traces to errors logged
2023-06-11 #30: switch to logging
2023-06-11 #30: include derived heater_power field in /api/log_data
2023-06-12 added SRP5030C footprint library for latest buck regulator SMD inductor
2023-06-12 shift template designator/value locations for SRP5030C footprint in library. Update hestia PCB with SRP5030C footprint for L2 on buck regulator. change D7 footprint from SOT23 to smaller SOT-323 as p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
    [buck_converter.kicad_sch, heater.kicad_sch, hestia.kicad_pcb]
2023-06-14 #30: switch web API to local time
2023-06-14 #30: change I2C logging to debug
2023-06-14 #30: return a unit in the sensor info payload
2023-06-14 #30: add /api/status POST API for updates
    - add TargetSensor enum replacing u8 for consistent validation
    - add post_status() for handling POSTs
    - add BoardStatusUpdate struct for JSON payload
2023-06-14 #30: static website for hestia-sat JSON API
    - supports multi-board API (just by hard-coding board #2 currently)
    - shows heater power in status box, and V/I/P on chart
    - adds target sensor selection
    - changes core temperature to target sensor temperature
    - uses units for board tooltip values
2023-06-14 #30: handle multiple boards correctly in status updates
    [main.rs]
2023-06-14 #30: fix target sensor control
2023-06-14 #28: bump version to 2.1
    [heater.kicad_sch, hestia.kicad_pcb, hestia.kicad_sch]
2023-06-14 #28: update KiBot configuration for KiCAD 7
2023-06-14 #28: disable DRC until we can fix new errors from KiCAD 7
    [hestia.kibot.yml]
2023-06-14 #28: ignore dangling labels in ERC, download 3D models, fix more KiCAD 6->7 config
    [hestia.kibot.yml]
2023-06-14 added new themal switch footprint to hestia lib. Added 3 wire restraint hole footprints -> 1.2mm, 1.8mm and 1.9mm. Change adc wire restraint holes (H9 to H13) to 1.8mm. Change uC wire restraint holes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
    [heater.kicad_sch, hestia.kicad_pcb, hestia.kicad_sch]
2023-06-15 #30: tidy up board update code
2023-06-15 #30: round the target temperature for display
2023-06-15 #33: fix uts-log failure when day rolls over (resolves #33)
    [config.rs, main.rs]
2023-06-15 #30: log boards configured at startup
2023-06-15 #30: enable pins for I2C1 on BBB at boot
2023-06-15 change R40 (blue LED current limiting resistor) schematic value to 100R as was specified for it's digikey resistor part number. It had been agreed that the blue LED intensity at 100R was acceptable
    [hestia.kicad_sch]
2023-06-15 change R8 (red led current limiting resistor) value from 100R to 180R to reduce intensity. Digikey part number for R8 changed for a 180R resistor
    [hestia.kicad_sch]
2023-06-16 #30: set UTF-8 charset on JSON responses (Safari doesn't default correctly)
    [main.rs]
2023-06-16 #30: add log file download, uts-web now feature complete
    - use API to get available log files, and render via JS
    - change /api/log_files to return name + url struct
    - error handling for missing data in JS
    - return log files with the newest first
    [log_data.rs, main.rs]
2023-06-16 Moved U1 designator due to DRC violation. Moved C1 designator due to DRC violation after SW2 footprint was previously changed and shifted. Moved C26 designator due to DRC violation after SW2 footprin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
    [hestia.kicad_pcb]
2023-06-16 Adding footprint library files for footprints Wire restraint Hole 1.2mm, 1.8mm and 1.9mm. A recollection was that these files had already been added recently. Perhaps the add command was executed inc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
2023-06-16 Added pcb trace to C13 to satisfy minimum-of-2 thermal relief spokes DRC violation. Moved U3 designator for better clarity. Added pcb trace to U3 pin 9 to satisfy minimum-of-2 thermal relief spokes D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
    [hestia.kicad_pcb]
2023-06-17 Updated TP4 TestPoint footprint from newer Kicad 7 footprints library due to DRC warning re: mismatch of part in design vs part in referenced library. Updated R26 NetTie footprint from newer Kicad 7 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
    [hestia.kicad_pcb, hestia.kicad_sch]
2023-06-17 Added four new footprints to hestia library: SpiralBlue Logo, SmartSatCRCLogo, a second different size Mawson Rovers Logo with a suffix 2, A second UTS logo with suffix 2- it wasn't clear if it was a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
    [hestia.kicad_pcb]
2023-06-17 Added extra PCB trace on C8 pin2 for extra ground current path. Shifted VCC via at x=136.56,y=148.12 slightly to allow extra connection path on VCC internal plane. Widen VCC path at J1 and J2 with pc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
    [hestia.kicad_pcb]
2023-06-18 Moved designator C16 and reduce font size slightly for better clarity and avoid via holes. Moved R5 designator for better clarity and avoid two via holes. Moved R40 designator for better clarity and 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
    [hestia.kicad_pcb]
2023-06-19 #34: update green LED behaviour to indicate PID heating
2023-06-19 #35: increase heater resistance to ~2.5Ω by decreasing track width
    [hestia.kicad_pcb]
2023-06-20 #36: disable CORS by default
    - CORS is not needed with new reverse proxy setup
    - whitelist of hosts doesn't have beaglebone.local, etc. in it - need to add this when we set up the real site later
    [config.rs, main.rs]
2023-06-20 #37: error handling for invalid lines in CSV log files
    [log_data.rs]
2023-06-20 #37: rename PWM to heater_duty everywhere
2023-06-20 #39: heater duty returns a u16
2023-06-20 #39: show heater_duty on the chart
2023-06-20 #40: make firmware compatible with v1.1 boards
    - expose I2C interface for board version
    - adapt LEDs based on board version
2023-06-21 #40: configurable support for v1.1 and v2 boards
    - disable U4 on v1.1 boards
    - toggle ADS7828 address based on board version
    - new DisabledSensor type that always returns a read error
    - tested with boards H113 and H202
    [ads7828.rs, board.rs, config.rs, lib.rs, main.rs, reading.rs]
2023-06-21 #40: switch green and yellow LED behaviour for consistency with v1.1 boards
2023-06-21 #32: log other data even if check sensor fails
    - remove check sensor setting
    - only prevent data logging if every sensor is an error
    [board.rs, config.rs]
2023-06-21 #40: allow higher temperature setpoints for testing
2023-07-03 #35: add TP7 low side heater test point to schematic
    [heater.kicad_sch]
2023-07-03 #35: add TP7 1x1mm test point to PCB
    [hestia.kicad_pcb]
2023-07-03 #35: change heater trace width to 0.15mm
    [hestia.kicad_pcb]
2023-07-03 #35: add heat high/low TP labels to silkscreen
    [hestia.kicad_pcb]
2023-07-03 reroute current amp out with option resistor to current amp in to directly measure voltage on that side of the current sense resistor. Via added to assist that signal route. add series resistor to cu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
    [heater.kicad_sch, hestia.kicad_pcb, hestia.kicad_sch]
2023-07-03 #44: add debug logging to show when sensors are disabled based on board version
2023-07-10 #41: board v2.1 submitted, update version ready for next iteration
    [hestia.kicad_pcb, hestia.kicad_sch]
2023-07-11 #49: fix crash when target_temp read fails
    [main.rs]
2023-07-11 #49: add stub i2c impl for testing
2023-07-11 #49: move conditional compilation into device module
2023-07-17 #50: build an event stream from the board readings
2023-07-17 #50: add payload wrapper around Vec<Board>
2023-07-17 #50: control the heater with state changes
2023-07-18 #50: program fixes and improvements:
    - heater program now completes if top and bottom board connected
    - logging when heat/cool periods finish
    - loop option to keep running programs indefinitely
    - change run_programs args to both be iterators
    [main.rs, programs.rs]
2023-07-19 #50: program fixes and improvements:
    - replace cool_time with cool_temp
    - fix abort temp
    - add default 1.0 for heat_duty
    - add program names and IDs
    - less verbose logging
    - add PayloadController for operations so state objects are cleaner
    [main.rs, programs.rs]
2023-07-20 #55: add PC/104 template for hole alignment
2023-07-20 #55: add 3D model for Pico-Lock header
    [Molex_Pico-Lock_504050-0691_1x06-1MP_P1.50mm_Horizontal.step]
2023-07-20 #55: move holes H6, H7, H8 to align with PC/104
    - move TP5, C54, U6, C29, C30 up to make room for H6 change
    - simplify SCL_3.3V routing
    [hestia.kicad_pcb]
2023-07-20 #55: move PC/104 connectors to align with template
    [hestia.kicad_pcb]
2023-07-24 #55: move drill origin to (100,150)
    [hestia.kicad_pcb]
2023-07-24 #55: align bottom of board to grid, y=150
    [hestia.kicad_pcb]
2023-07-24 repositioned H5,H6,H6 & H8 footprint origins to the correct coordinates (instead of just the pads which seems like something I might have done in the past. Also in the past i probably then updated th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
    [hestia.kicad_pcb]
2023-07-27 Update board and schematic version ahead of next iteration
    [hestia.kicad_pcb, hestia.kicad_sch]
2023-07-27 #56: allow running programs with just one board
2023-08-10 #57: add software thermal limit at 120°C
    - add configurable max_temp
    - add check for max_temp in heater_process
    - add board status flag which can indicate max_temp reached
    - add I2C commands for read/write max_temp
    - update ADC values to match thermistor model used in v2 boards
    - tested on board H203 and i2cget to check values
2023-08-10 #58: fix looping
    - recreate program list and event stream between loops
    [main.rs]
2023-08-11 turn off heater if program stopped with Ctrl+C
2023-08-14 Update firmware version for v2.2 boards
2023-08-15 fix current value display for board v2.2
    [main.rs]
2023-08-15 #29: only read voltage & current measurement ADCs when PWM is toggled on
2023-08-15 #29: calculate rolling average for ADC readings
    - new data available on I2C addr 0x31-0x38
    - tested with board H226 with PWM and PID heating
2023-08-15 #29: fix overflow in ema_start constant
    [main.c]
2023-08-15 Increase heater test time for use with heatsink
2023-08-19 Fix uts-cli on Mac
    [max31725.rs, stub_i2c.rs]
2023-09-07 Fix CCS project for hestia-fw, switch to C99
2023-09-07 Use static strings for board and sensor IDs
    - introduce BoardId type
2023-09-07 Fix JSON serialization of BoardId
    [board.rs]
2023-09-08 #47: Update dashboard to support two boards
    - use "top" and "bottom" as board IDs in JSON API instead of 1 and 2
    - switch to tailwind for styling
    - new build.sh and run.sh to build and run standalone server
    - add -top and -bottom to controls in HTML
    - update JS to set values for each board
    - still some things to get working
    - new design needs more work and testing on different screen sizes
2023-09-08 #47: Fix target sensor labels
2023-09-08 #47: serialise BoardId as top/bottom for JSON API
    - remove redundant HeatBoard enum
    - update BoardId enums to match standard naming
    - change parameter from "board_id" to "board" in status update API
2023-09-08 #47: log writes done through stub I2C
2023-09-08 add APIs to read board version from I2C 0x10
2023-09-08 #47: pass correct board ID when doing updates
2023-09-09 #47: fix board chart data
2023-09-10 #47: ensure only one heater can be turned on
2023-09-12 #47: lots of UI updates
    - new colour scheme for temp chart
    - only show relevant series on temp chart
    - change heatmap to put background image in chart
    - move heatmaps up near board status
    - use colour-coding to indicate temperature on board
    - update Hestia images to latest
    - more discreet flip trigger
    - hide long log file list
2023-09-12 #51: fix log file download file names
    [main.rs]
2023-09-12 #47: make red lower temp on heatmap
2023-09-16 Flash green LED at startup
2023-09-21 #61: fixes to thermostat PID loop:
    - change error_sum from i16 to i32 so it can't overflow
    - change error_sum to contain shifted (divided) I value like in Arduino PID
    - clamp error_sum to avoid integral windup
    - reduce P and I terms to 3
    [main.c]
2023-09-22 #47: fix calculations for heater power on v2.2 boards
    - centralise calculations in board module
    - static and Board calc methods
    - assume logs are always v2.2 boards, since no version logged
    [board.rs, log_data.rs, main.rs, status.rs, test.rs]
2023-09-22 #29: add rolling average values to log and use in UIs
    - fix unit tests
    - only add BBB libraries when cross-compiling
    [board.rs, build.rs, csv.rs, log_data.rs, main.rs, status.rs, test.rs]
2023-09-22 #29: low-pass filter to replace high values with zero in EMA for v_low and v_curr
    [main.c]
2023-09-22 #29: clamp power calc so it can't be <0.0
2023-09-22 #29: use rolling averages for PWM mode too
2023-09-26 #29: web: read heater_power from CSV
2023-09-26 #65: Fix warnings from Clippy
    [ads7828.rs, board.rs, build.rs, csv.rs, i2c.rs, lib.rs, log_data.rs, main.rs]
2023-09-27 #65: fix board config for uts-web
2023-10-16 Adding log file used in tests
    [uts-data-2023-08-16-raw.csv]
2023-10-23 #67 change stderr output to error log
    [csv.rs]
2024-01-16 #63: update footprint for LTC4313-1 to match spec
    - updated U9 footprint and 3D model
    - moved a few pin 1 indicators closer to their chips
    - fixed TP5 inconsistency between schematic & pcb
    [hestia.kicad_pcb, hestia.kicad_sch]
2024-01-16 Flight model test data
    [uts-data-1970-01-01-raw.csv, uts-data-1970-01-01.csv, ws1-test-2023-09-26.xlsx]
2024-01-16 #74 Compress log files
    First cut at this implementation. Log files will be compressed using
    bzip2 when the UTS_COMPRESS_LOGS option is set.
    Still to do: check appending to existing logs; rename files to use
    .bzip2 extension.
2024-01-21 #76 Run command for tvac programs
    This adds a "run" command to `uts-cli` which will take a program name and
    look for a toml file with that name from the current directory.
    The command execs `uts-run` which it expects to find in the current
    directory.
2024-01-25 #73 switch to gzip compression
2024-02-07 #87 Fix warning about unused arguments
    [host.rs]
2024-02-09 #88 Ensure heaters disabled at program start
2024-02-28 #90 CLI command improvements
    - only require -b when multiple boards connected
    - respect UTS_I2C_BUS config in heater changes
    - tests for Payload indexing
2024-02-29 #93: fix payload enable/disable
    - GPIO updates via /sys/class/gpio have a race condition
    - Add 100ms pauses after fs updates to ensure they propagate through
    - There may be a better way to do this, but we don't have one right now
    [gpio.rs, mod.rs]
2024-08-12 #68: port hestia-fw changes from Hestia 2W to fix ADC measurement during PWM (7e338ea, f9100cd):
    - fix bug with CPU not sleeping in main loop
    - align ADC timing with PWM
    - during PWM, only capture ADC readings when "on"
    - reduce ADC sample time to speed it up
    - disable moving average calculations
    - SMCLK changed to 16 MHz for testing even faster ADC
    - updated timer A settings to work with faster SMCLK
    - limit PWM to max 255
    [main.c, main.h]
2024-11-13 KiCad 8 updates
2024-12-19 FT-4 with longer heating times
2025-02-05 FT-5 for power comparison and thermostat test
